ibnusina339/Remora/docs/UNRELEASED.md

# Perubahan belum dirilis

Perubahan sesi ini dikumpulkan pada [catatan v0.3.0](releases/v0.3.0.md). Belum ada perubahan tambahan yang dicatat.

Auto Off dan perbaikan temuan board: [v0.4.0](releases/v0.4.0.md).
