ibnusina339/Remora/docs/releases/v0.4.2.md

# REMORA v0.4.2

27 Oktober 2026

- Koneksi untuk SSID yang memiliki beberapa akses poin memindai seluruh kanal dan mengutamakan sinyal terkuat. ESP32-C6 memakai radio 2,4 GHz; SSID dual-band dengan nama yang sama tetap memakai varian 2,4 GHz.
- Kanal dan BSSID tidak dikunci ke hasil koneksi lama. Batas RSSI ditetapkan eksplisit dan setiap akses poin diberi satu retry sebelum kandidat berikutnya dicoba. Ambang keamanan jaringan terbuka/WPA2 tetap dipertahankan.
- Perlindungan idle saat mencoba koneksi tetap 20 detik; ini bukan batas waktu keras driver. Timer hemat Wi-Fi dan perlindungan OTA tetap berlaku.
- Pengujian sumber jaringan kini 14 kasus, termasuk konfigurasi jaringan terbuka, terlindungi, dan koneksi ulang yang tersimpan. Peta partisi dan userdata schema tetap sama; profil dan rekor tidak dihapus.

Tidak ada dukungan radio 5 GHz yang ditambahkan: ini batas hardware ESP32-C6. Jika varian 2,4 GHz SSID tidak terjangkau, koneksi tidak dapat digantikan dengan varian 5 GHz.

Rujukan konfigurasi: [header ESP-IDF 5.5.2](https://github.com/espressif/esp-idf/blob/v5.5.2/components/esp_wifi/include/esp_wifi_types_generic.h), [spesifikasi C6](https://www.espressif.com/en/products/socs/esp32-c6).
