ibnusina339/Remora/assets/cat-sprites/bowl-cutout.png

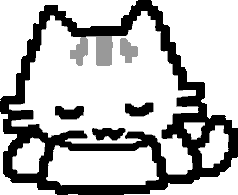
assets/cat-sprites/bowl-cutout.png
