ibnusina339/Remora/assets/cat-sprites/groom-cutout.png

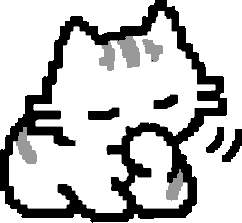
assets/cat-sprites/groom-cutout.png
