ibnusina339/Remora/assets/cat-sprites/happy-cutout.png

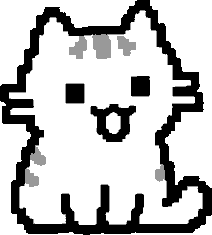
assets/cat-sprites/happy-cutout.png
