ibnusina339/Remora/assets/cat-sprites/peek-cutout.png

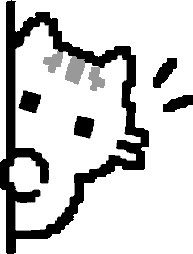
assets/cat-sprites/peek-cutout.png
