ibnusina339/Remora/assets/cat-sprites/roll-cutout.png

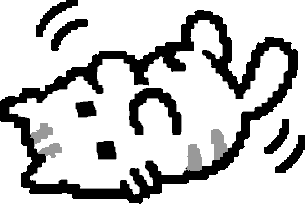
assets/cat-sprites/roll-cutout.png
