ibnusina339/Remora/assets/cat-sprites/secretStand-cutout.png

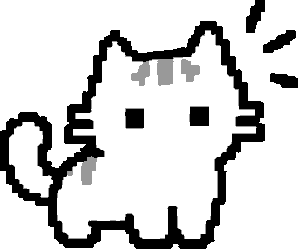
assets/cat-sprites/secretStand-cutout.png
