ibnusina339/Remora/assets/cat-sprites/sit-cutout.png

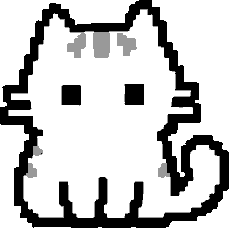
assets/cat-sprites/sit-cutout.png
