ibnusina339/Remora/assets/cat-sprites/sit.png

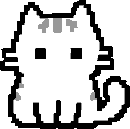
assets/cat-sprites/sit.png
