ibnusina339/Remora/assets/cat-sprites/sleep-cutout.png

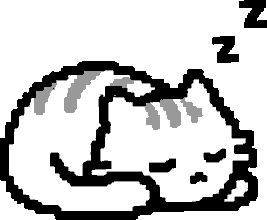
assets/cat-sprites/sleep-cutout.png
