ibnusina339/Remora/assets/cat-sprites/source-sheet.png

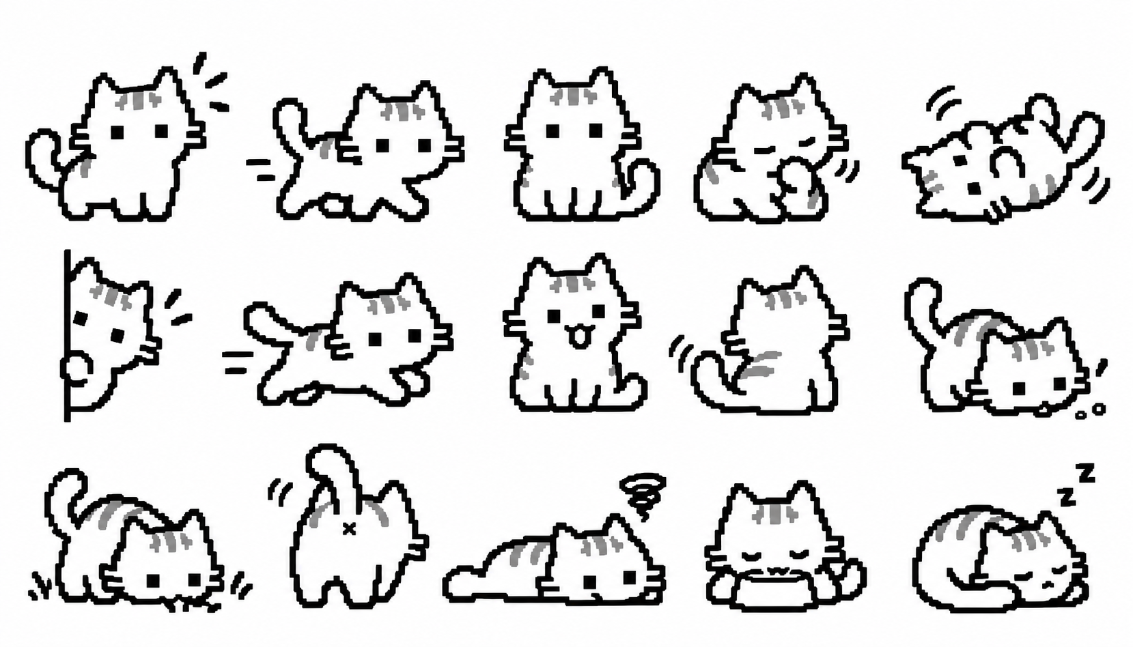
assets/cat-sprites/source-sheet.png
