ibnusina339/Remora/assets/cow-sprites/alert-cutout.png

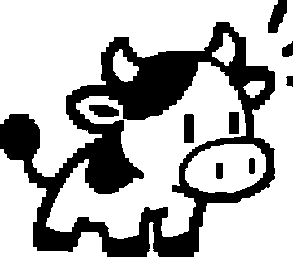
assets/cow-sprites/alert-cutout.png
