ibnusina339/Remora/assets/cow-sprites/back-cutout.png

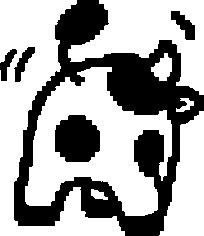
assets/cow-sprites/back-cutout.png
