ibnusina339/Remora/assets/cow-sprites/drink-cutout.png

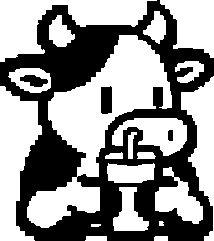
assets/cow-sprites/drink-cutout.png
