ibnusina339/Remora/assets/cow-sprites/easy-cutout.png

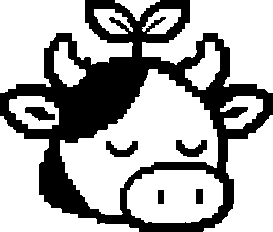
assets/cow-sprites/easy-cutout.png
