ibnusina339/Remora/assets/cow-sprites/expert-cutout.png

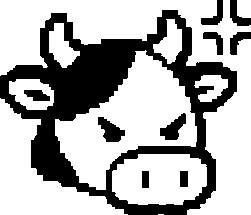
assets/cow-sprites/expert-cutout.png
