ibnusina339/Remora/assets/cow-sprites/graze-cutout.png

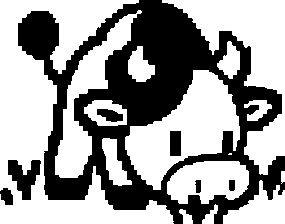
assets/cow-sprites/graze-cutout.png
