ibnusina339/Remora/assets/cow-sprites/happy-cutout.png

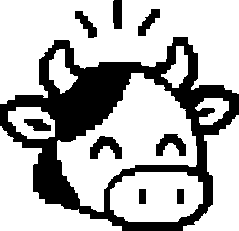
assets/cow-sprites/happy-cutout.png
