ibnusina339/Remora/assets/cow-sprites/hard-cutout.png

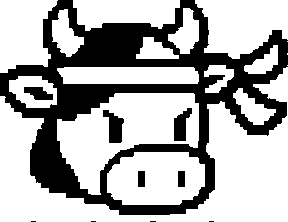
assets/cow-sprites/hard-cutout.png
