ibnusina339/Remora/assets/cow-sprites/jump-cutout.png

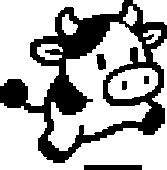
assets/cow-sprites/jump-cutout.png
