ibnusina339/Remora/assets/cow-sprites/listen-cutout.png

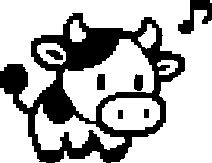
assets/cow-sprites/listen-cutout.png
