ibnusina339/Remora/assets/cow-sprites/master-cutout.png

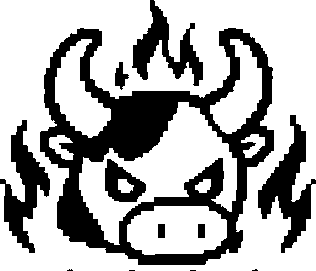
assets/cow-sprites/master-cutout.png
