ibnusina339/Remora/assets/cow-sprites/normal-cutout.png

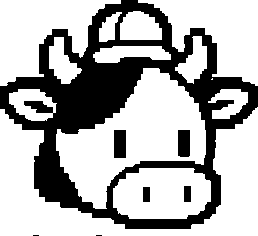
assets/cow-sprites/normal-cutout.png
