ibnusina339/Remora/assets/cow-sprites/peek-cutout.png

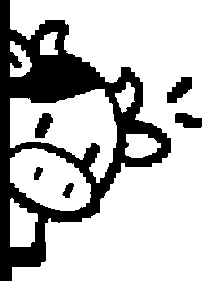
assets/cow-sprites/peek-cutout.png
