ibnusina339/Remora/assets/cow-sprites/pingpong-cutout.png

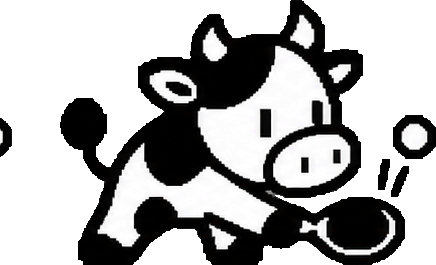
assets/cow-sprites/pingpong-cutout.png
