ibnusina339/Remora/assets/cow-sprites/roll-cutout.png

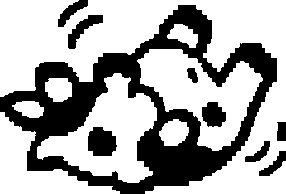
assets/cow-sprites/roll-cutout.png
