ibnusina339/Remora/assets/cow-sprites/run-cutout.png

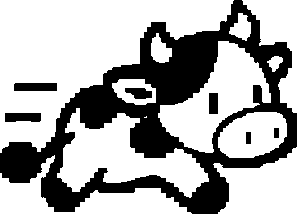
assets/cow-sprites/run-cutout.png
