ibnusina339/Remora/assets/cow-sprites/sad-cutout.png

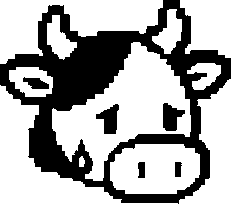
assets/cow-sprites/sad-cutout.png
