ibnusina339/Remora/assets/cow-sprites/sit-cutout.png

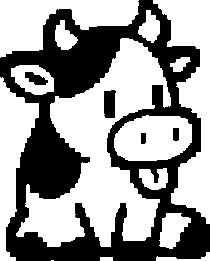
assets/cow-sprites/sit-cutout.png
