ibnusina339/Remora/assets/cow-sprites/sleep-cutout.png

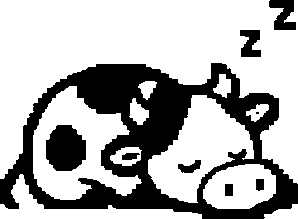
assets/cow-sprites/sleep-cutout.png
