ibnusina339/Remora/assets/cow-sprites/snake-cutout.png

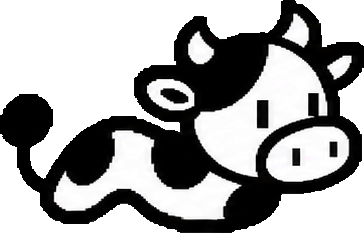
assets/cow-sprites/snake-cutout.png
