ibnusina339/Remora/assets/cow-sprites/source-pong-sheet.png

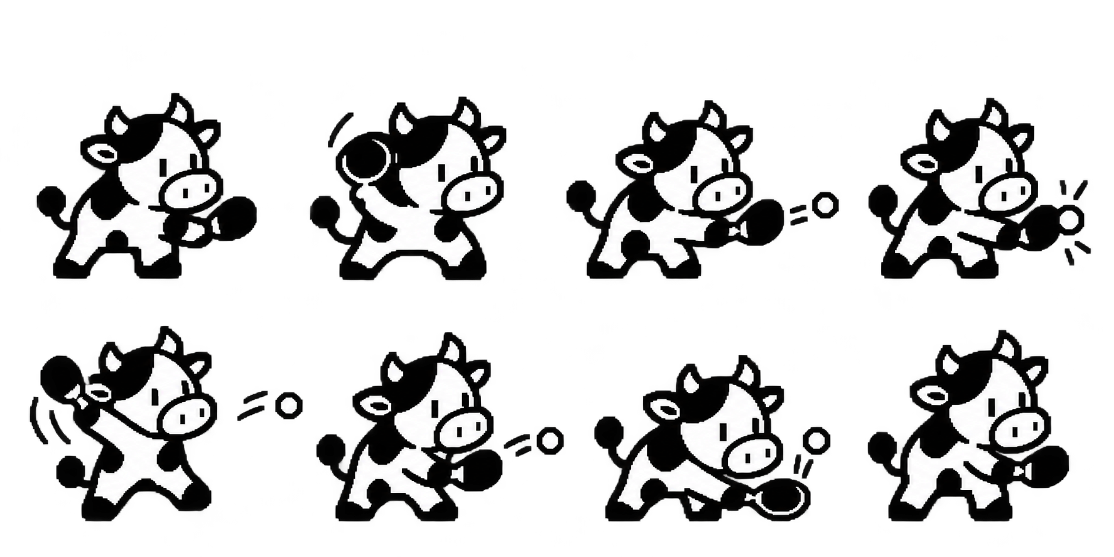
assets/cow-sprites/source-pong-sheet.png
