ibnusina339/Remora/assets/cow-sprites/source-snake-sheet.png

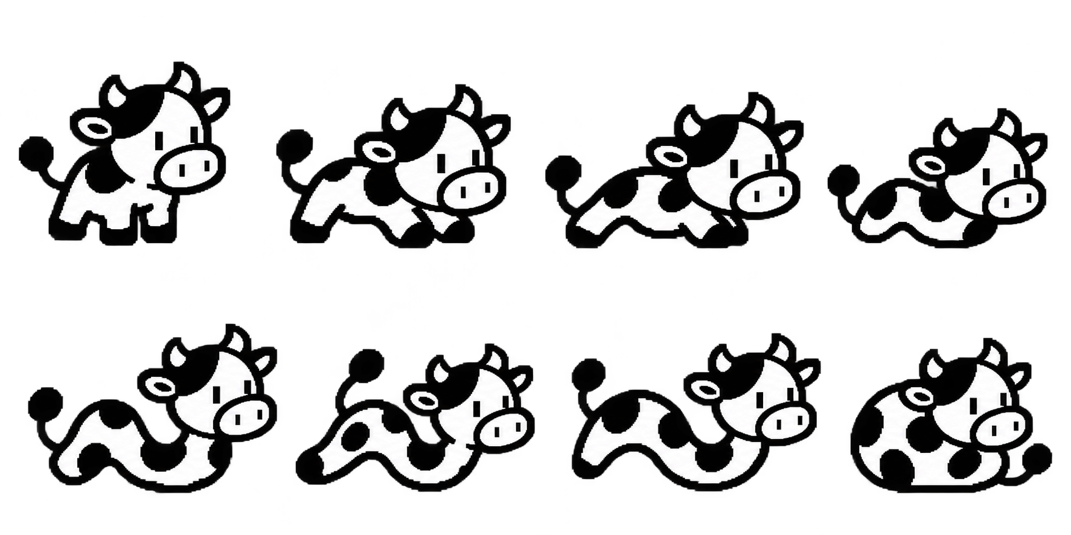
assets/cow-sprites/source-snake-sheet.png
