ibnusina339/Remora/assets/cow-sprites/stand-cutout.png

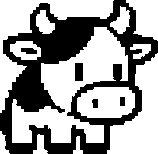
assets/cow-sprites/stand-cutout.png
