ibnusina339/Remora/assets/cow-sprites/surprised-cutout.png

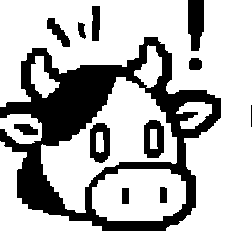
assets/cow-sprites/surprised-cutout.png
