ibnusina339/Remora/assets/cow-sprites/think-cutout.png

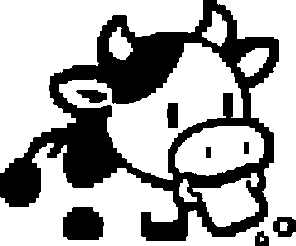
assets/cow-sprites/think-cutout.png
