ibnusina339/Remora/assets/remora-logo-fusion-r12.dxf

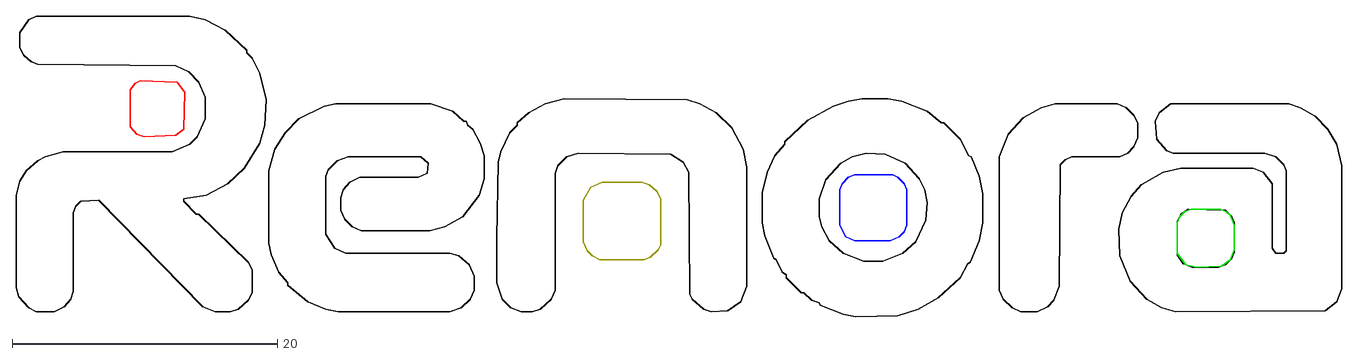
[picture p36: CAD file, 2026-10-23]
assets/remora-logo-fusion-r12.dxf
100.0 x 22.7
