ibnusina339/Remora/docs/hardware/REMORA_Schematic_Rev_K2_A4.pdf

# REMORA Schematic

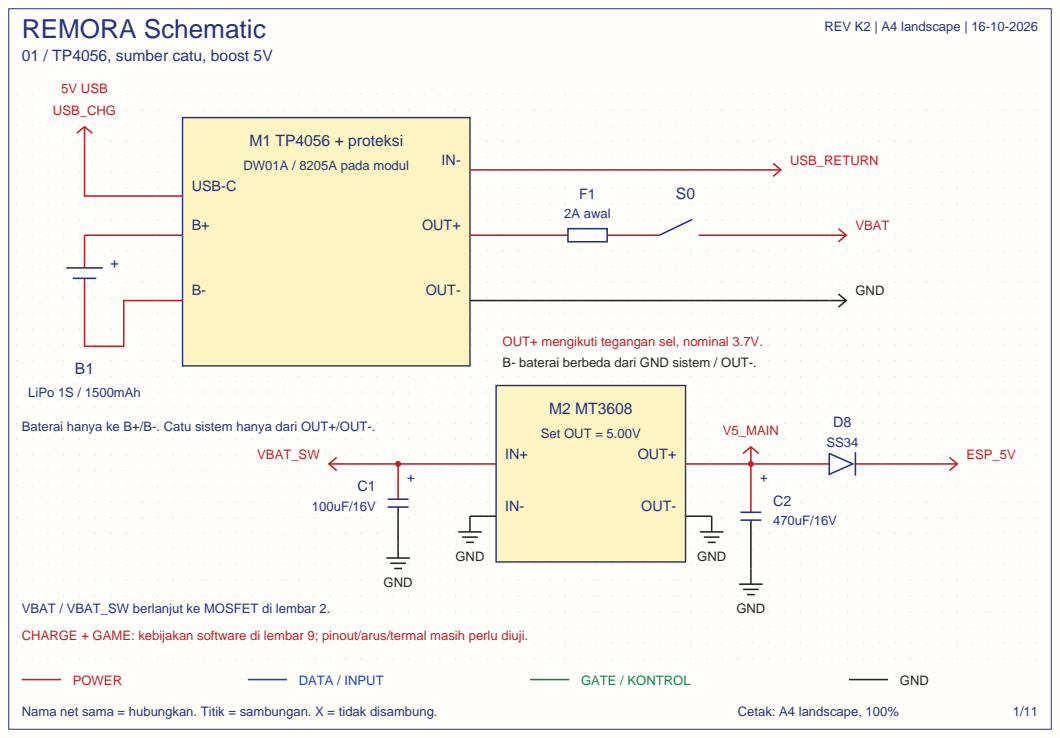
[picture p37: page 1]
REV K2 | A4 landscape | 16-10-2026; POWER; DATA / INPUT; GATE / KONTROL; GND; Nama net sama = hubungkan. Titik = sambungan. X = tidak disambung.; Cetak: A4 landscape, 100%; M1 TP4056 + proteksi; DW01A / 8205A pada modul; USB-C; OUT+; OUT-; USB_RETURN; USB_CHG; 5V USB; LiPo 1S / 1500mAh; F1 2A awal; VBAT; Set OUT = 5.00V; VBAT_SW; V5_MAIN; ESP_5V

01 / TP4056, sumber catu, boost 5V

OUT+ mengikuti tegangan sel, nominal 3.7V.
B- baterai berbeda dari GND sistem / OUT-.

Baterai hanya ke B+/B-. Catu sistem hanya dari OUT+/OUT-.

VBAT / VBAT_SW berlanjut ke MOSFET di lembar 2.
CHARGE + GAME: kebijakan software di lembar 9; pinout/arus/termal masih perlu diuji.

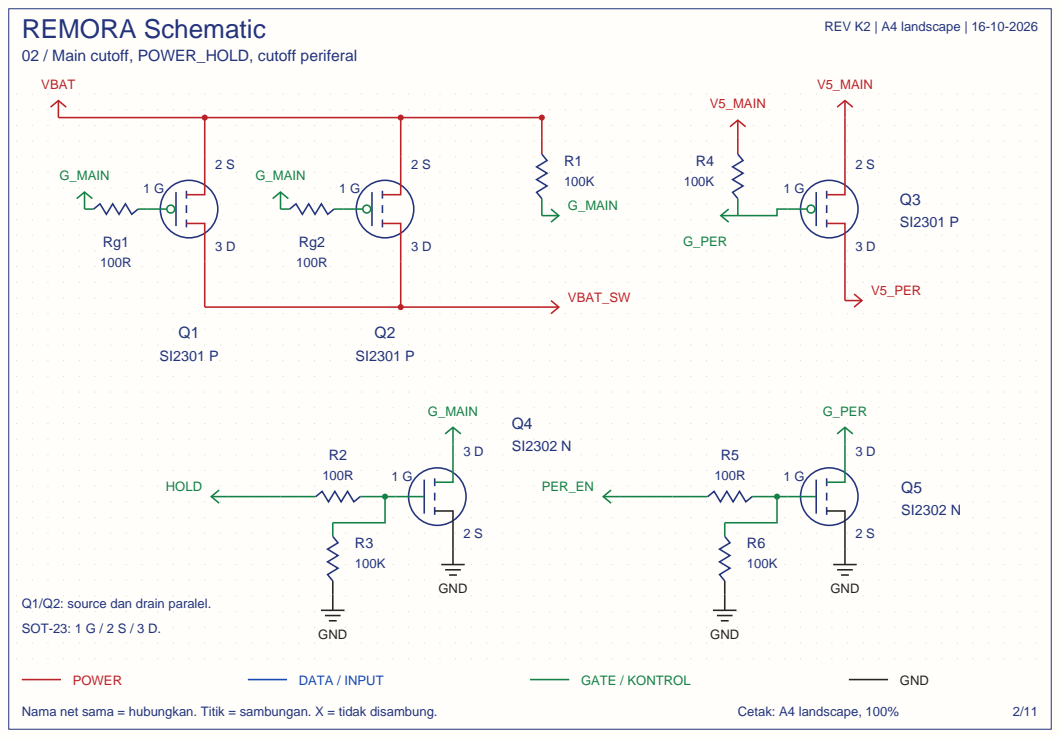
[picture p38: page 2]

02 / Main cutoff, POWER_HOLD, cutoff periferal

Q1/Q2: source dan drain paralel.
SOT-23: 1 G / 2 S / 3 D.

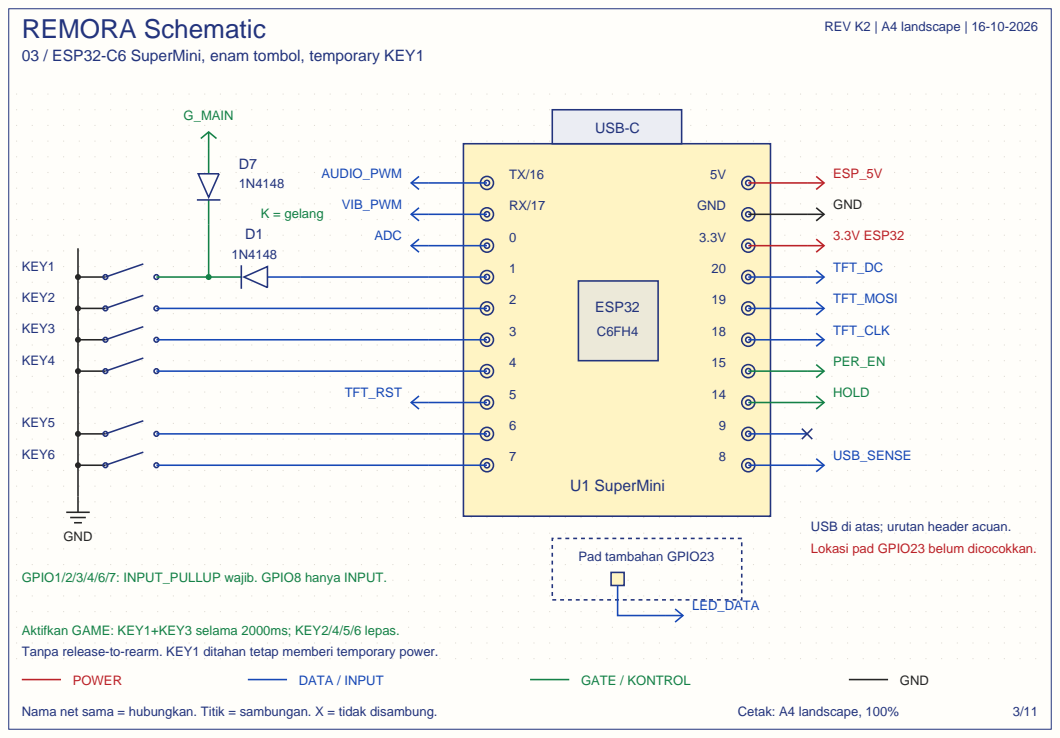
[picture p39: page 3]
POWER; DATA / INPUT; GATE / KONTROL; GND; Nama net sama = hubungkan. Titik = sambungan. X = tidak disambung.; Cetak: A4 landscape, 100%; USB-C; ESP32; U1 SuperMini; AUDIO_PWM; VIB_PWM; ADC; TFT_RST; ESP_5V; 3.3V ESP32; TFT_DC; TFT_MOSI; TFT_CLK; PER_EN; HOLD; USB_SENSE; Pad tambahan GPIO23; LED_DATA; KEY1; G_MAIN; K = gelang; KEY2; KEY3; KEY4; KEY5; KEY6

03 / ESP32-C6 SuperMini, enam tombol, temporary KEY1

USB di atas; urutan header acuan.
Lokasi pad GPIO23 belum dicocokkan.

GPIO1/2/3/4/6/7: INPUT_PULLUP wajib. GPIO8 hanya INPUT.

Aktifkan GAME: KEY1+KEY3 selama 2000ms; KEY2/4/5/6 lepas.
Tanpa release-to-rearm. KEY1 ditahan tetap memberi temporary power.

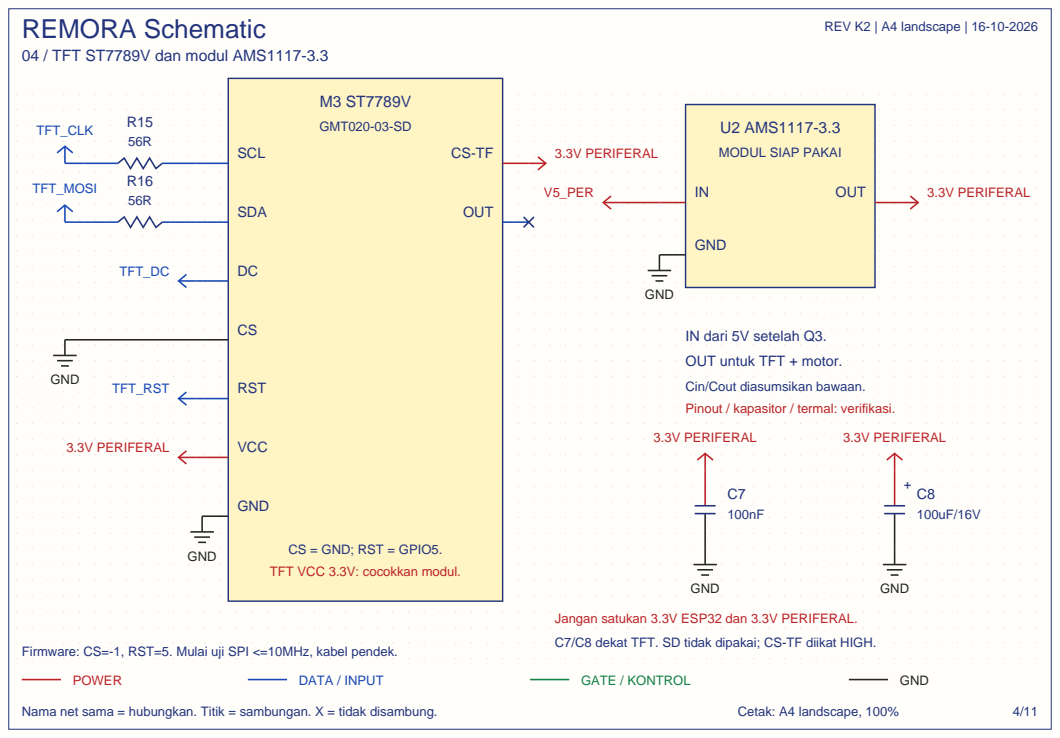
[picture p40: page 4]
POWER; DATA / INPUT; GATE / KONTROL; GND; Nama net sama = hubungkan. Titik = sambungan. X = tidak disambung.; Cetak: A4 landscape, 100%; GMT020-03-SD; SCL; SDA; RST; VCC; OUT; TFT_CLK; TFT_MOSI; TFT_DC; TFT_RST; 3.3V PERIFERAL; V5_PER

04 / TFT ST7789V dan modul AMS1117-3.3

U2 AMS1117-3.3
MODUL SIAP PAKAI (https://htmlapp.alldatasheet.com/html-pdf/205679/ADMOS/AMS1117/618/4/AMS1117.html)

IN dari 5V setelah Q3.
OUT untuk TFT + motor.
Cin/Cout diasumsikan bawaan.
Pinout / kapasitor / termal: verifikasi.

CS = GND; RST = GPIO5.
TFT VCC 3.3V: cocokkan modul.

Jangan satukan 3.3V ESP32 dan 3.3V PERIFERAL.

C7/C8 dekat TFT. SD tidak dipakai; CS-TF diikat HIGH. Firmware: CS=-1, RST=5. Mulai uji SPI <=10MHz, kabel pendek.

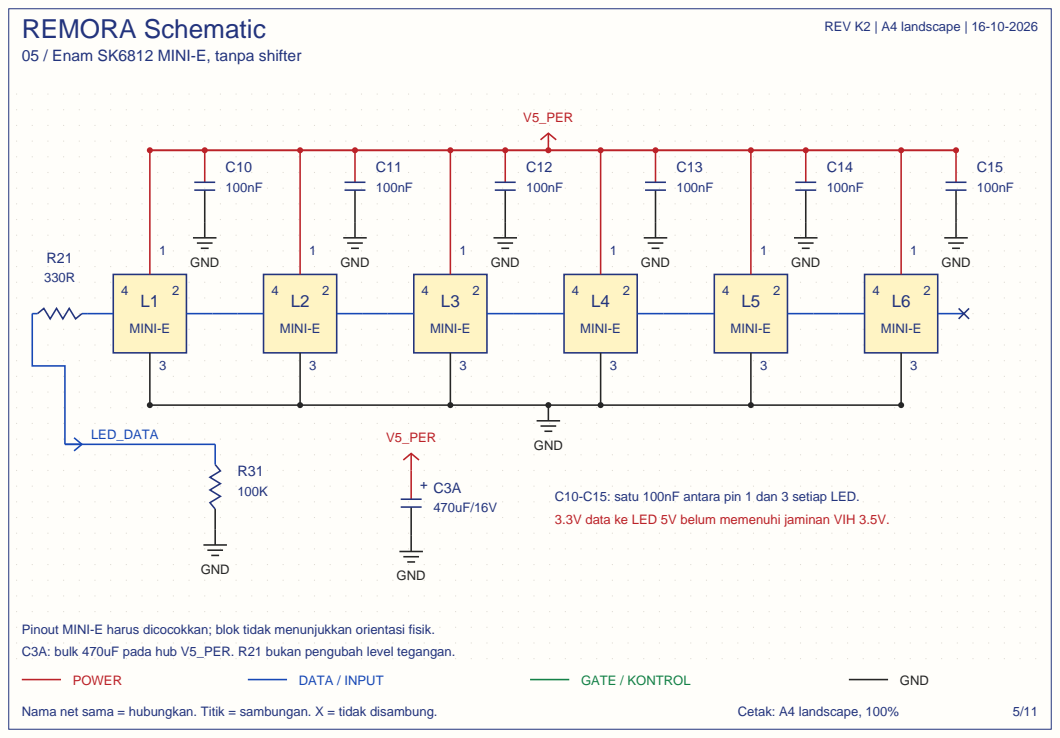
[picture p41: page 5]

05 / Enam SK6812 MINI-E, tanpa shifter

C10-C15: satu 100nF antara pin 1 dan 3 setiap LED.
3.3V data ke LED 5V belum memenuhi jaminan VIH 3.5V.

Pinout MINI-E harus dicocokkan; blok tidak menunjukkan orientasi fisik.
C3A: bulk 470uF pada hub V5_PER. R21 bukan pengubah level tegangan.

### 06 / Audio PWM, PAM8302A, speaker

POWER | DATA / INPUT | GATE / KONTROL | GND
Nama net sama = hubungkan. Titik = sambungan. X = tidak disambung. | Cetak: A4 landscape, 100% | 6/11

### M5 PAM8302A (https://cdn-shop.adafruit.com/datasheets/PAM8302A.pdf)

A+

A-

SD

Vin

GND

SPK+

SPK-

AUDIO_PWM R24 100K

C21
10nF

GND

R27
10K

GND

C23
100nF

GND

V5_PER

V5_PER

GND

### SPK1

8R / >=1W
+

C25
220uF/16V

+

V5_PER

GND

C25 dekat Vin / GND PAM8302.

PWM awal >=80kHz / 8 bit. Filter 1 tahap; respons audio belum diuji.
SD disatukan ke Vin: audio mengikuti cutoff Q3. Klik ON/OFF mungkin.

GPIO16 adalah TX saat boot; UI status hanya boleh setelah output disiapkan.

SPK+ dan SPK- hanya ke speaker; tidak ke GND.

### 07 / Modul vibration motor dan sensor baterai

POWER | DATA / INPUT | GATE / KONTROL | GND
Nama net sama = hubungkan. Titik = sambungan. X = tidak disambung. | Cetak: A4 landscape, 100% | 7/11

### M4 VIBRATION

DRIVER SUDAH PADA MODUL

IN

VCC

GND

VIB_PWM | R22 1K
VIB_IN

R30
100K

VIB_IN

GND

3.3V PERIFERAL

GND

C20
100uF/16V

+

3.3V PERIFERAL

GND

VCC 3.3V dan polaritas IN: cocokkan motor / driver.
C20 dekat modul motor; proteksi lonjakan bawaan belum diperiksa.

R12
100K

VBAT_SW

R13
47K

GND

ADC

C6
100nF

GND

ADC = GPIO0 pada lembar 3. Vbat_sw = Vadc x 147/47.
Pada 4.2V: ADC sekitar 1.343V. C6 dekat GPIO0; kalibrasi ADC.

KANDIDAT: pinout board, TP4056/LiPo, level LED dan uji listrik belum tervalidasi.

### 08 / PC817: deteksi USB untuk software lock; tanpa pemutus J1

POWER | DATA / INPUT | GATE / KONTROL | GND
Nama net sama = hubungkan. Titik = sambungan. X = tidak disambung. | Cetak: A4 landscape, 100% | 8/11

### U3 PC817

DIP4 / tampak atas (https://global.sharp/products/device/lineup/data/pdf/datasheet/PC817XxNSZ1B_e.pdf)

1 A

2 K

4 C

3 E

USB_CHG

R33
560R

USB_RETURN

USB_SENSE

R34
10K

3.3V ESP32

GND

Ke GPIO8 U1

USB TP masuk: GPIO8 LOW. USB TP dilepas: GPIO8 HIGH.
R33 560R membatasi IRED; sekitar 6.8mA pada USB 5V dan VF 1.2V.
R34 10K pull-up dari header 3.3V SuperMini / 3.3V ESP32; bukan 3.3V PERIFERAL. USB_RETURN ke IN- TP4056; GND ke OUT- TP4056. Jangan tambah jumper antar keduanya. GPIO8 hanya INPUT; nonaktifkan driver LED RGB bawaan pada GPIO8. (https://docs.espressif.com/projects/esp-idf/en/stable/esp32c6/api-reference/peripherals/gpio.html)
J1/Q6 pemutus dihapus. Catu ESP tetap melalui D8 pada lembar 1.
Standby: HOLD HIGH ditahan; PER_EN LOW; gunakan Light-sleep. (https://docs.espressif.com/projects/esp-idf/en/stable/esp32c6/api-reference/system/sleep_modes.html)
PC817 memisahkan jalur deteksi; tidak mengisolasi seluruh perangkat / charger.
Flash USB ESP: S0 OFF + USB TP dilepas. GPIO9 HIGH saat boot SPI normal.
S0 OFF: tidak ada popup otomatis. Validasi pinout DIP, LOW/HIGH GPIO8 dan arus standby.

### 09 / Software lock dan tampilan status dari standby

POWER | DATA / INPUT | GATE / KONTROL | GND
Nama net sama = hubungkan. Titik = sambungan. X = tidak disambung. | Cetak: A4 landscape, 100% | 9/11

Estimasi baterai dari ADC bukan pengukur kapasitas yang presisi. (https://www.ti.com/product-category/battery-management-ics/battery-fuel-gauges/overview.html)
Lock 80% memblokir GAME; pengisian tetap berjalan sampai USB dilepas.
MAIN OFF | S0 OFF / proteksi terputus | Tidak ada popup otomatis. Nyalakan dengan tombol setelah catu tersedia.
PLAY | KEY1+KEY3 valid 2 detik; tidak ada low lock / charge lock | Game boleh berjalan saat USB TP terpasang, selama estimasi belum mencapai lock 80%.
LOCK 80% | USB TP hadir dan estimasi >=80% | Pause/simpan game; tampilkan perintah cabut USB. Setelah 2 detik, periferal OFF; ESP standby.
LOW 5% | Estimasi <=5% atau low-voltage warning hasil kalibrasi | Game berhenti; tampilkan baterai rendah 2 detik. Standby; game dibuka setelah pulih, contoh >=10%.
USB POPUP | USB TP dipasang saat standby | Tampilkan USB terhubung + estimasi persen 2 detik. Kembali standby; ini bukan pembuktian arus charge.
RESUME | USB dilepas setelah lock 80%; baterai cukup untuk bermain | Buka lock; lanjutkan dengan combo 2 detik. KEY1/KEY3 tetap input game tanpa release-to-rearm.

Standby: HOLD HIGH + pad hold; PER_EN LOW + semua output periferal LOW. (https://docs.espressif.com/projects/esp-idf/en/stable/esp32c6/api-reference/peripherals/gpio.html)
Wake GPIO8 pada level berikutnya (USB masuk/lepas); jangan arm level yang sudah aktif. GPIO wake Light-sleep: domain GPIO tetap ON. KEY1 membangunkan; timer memantau ADC. (https://docs.espressif.com/projects/esp-idf/en/stable/esp32c6/api-reference/system/sleep_modes.html) Tambahkan batas tegangan kritis sesuai sel: cutoff penuh bila perlu; persentase bukan proteksi.

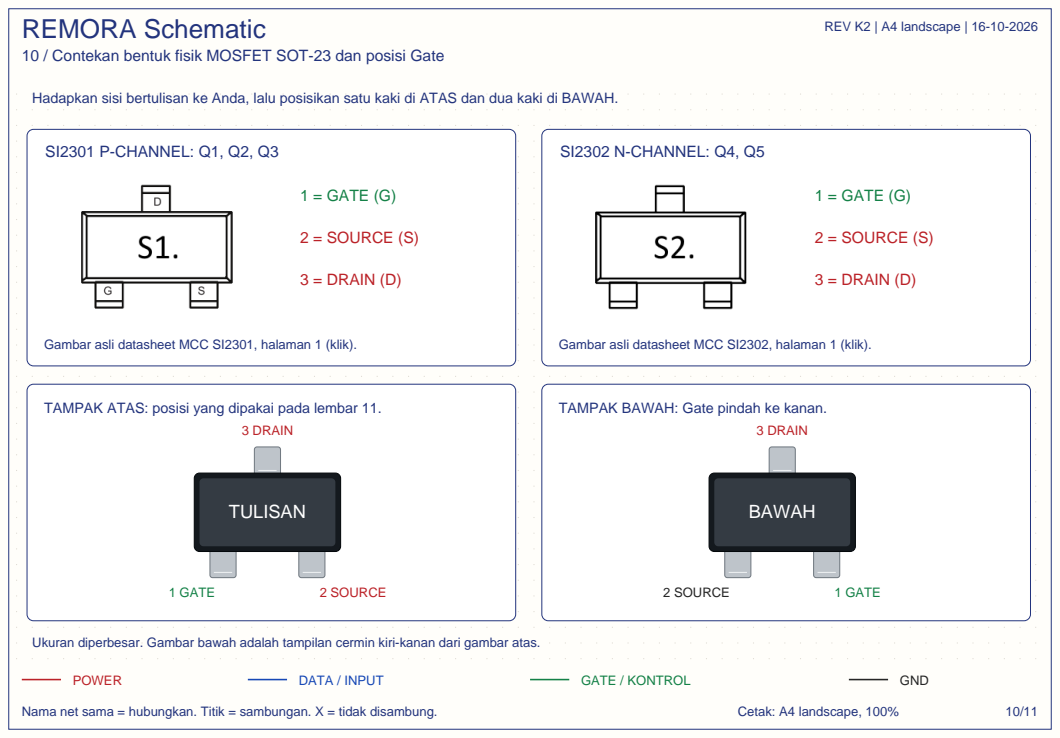
[picture p42: page 10]
POWER; DATA / INPUT; GATE / KONTROL; GND; Nama net sama = hubungkan. Titik = sambungan. X = tidak disambung.; Cetak: A4 landscape, 100%; SI2301 P-CHANNEL: Q1, Q2, Q3; 1 = GATE (G); 2 = SOURCE (S); 3 = DRAIN (D); SI2302 N-CHANNEL: Q4, Q5; TAMPAK ATAS: posisi yang dipakai pada lembar 11.; TAMPAK BAWAH: Gate pindah ke kanan.; TULISAN; 3 DRAIN; 1 GATE; 2 SOURCE; BAWAH

10 / Contekan bentuk fisik MOSFET SOT-23 dan posisi Gate

Hadapkan sisi bertulisan ke Anda, lalu posisikan satu kaki di ATAS dan dua kaki di BAWAH.

Gambar asli datasheet MCC SI2301, halaman 1 (klik). (https://www.mccsemi.com/pdf/Products/SI2301(SOT-23).pdf)

Gambar asli datasheet MCC SI2302, halaman 1 (klik). (https://www.mccsemi.com/pdf/Products/SI2302(SOT-23).pdf)

Ukuran diperbesar. Gambar bawah adalah tampilan cermin kiri-kanan dari gambar atas.

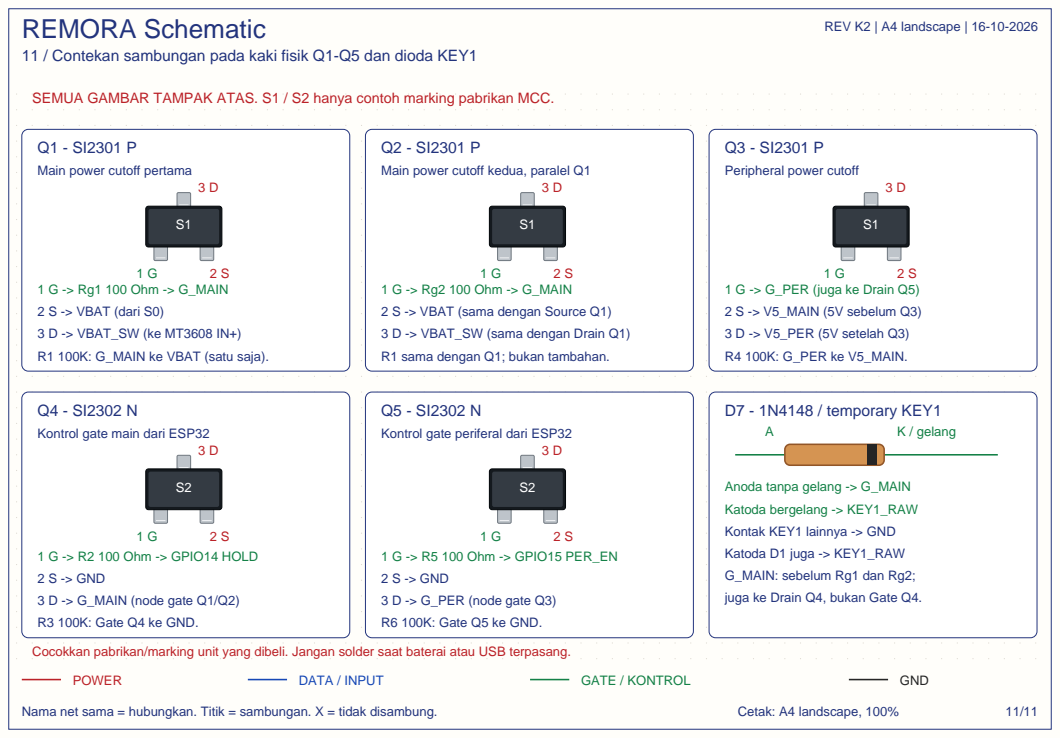
[picture p43: page 11]

11 / Contekan sambungan pada kaki fisik Q1-Q5 dan dioda KEY1

SEMUA GAMBAR TAMPAK ATAS. S1 / S2 hanya contoh marking pabrikan MCC.

Main power cutoff pertama

Main power cutoff kedua, paralel Q1

1 G -> Rg1 100 Ohm -> G_MAIN
2 S -> VBAT (dari S0)
3 D -> VBAT_SW (ke MT3608 IN+)
R1 100K: G_MAIN ke VBAT (satu saja).

1 G -> Rg2 100 Ohm -> G_MAIN
2 S -> VBAT (sama dengan Source Q1)
3 D -> VBAT_SW (sama dengan Drain Q1)
R1 sama dengan Q1; bukan tambahan.

Kontrol gate main dari ESP32

Kontrol gate periferal dari ESP32

Anoda tanpa gelang -> G_MAIN
Katoda bergelang -> KEY1_RAW
Kontak KEY1 lainnya -> GND
Katoda D1 juga -> KEY1_RAW
G_MAIN: sebelum Rg1 dan Rg2;
juga ke Drain Q4, bukan Gate Q4.

Cocokkan pabrikan/marking unit yang dibeli. Jangan solder saat baterai atau USB terpasang.
