ibnusina339/Remora/firmware/esp32c6/components/remora_board/src/audio.cpp

#include "board.hpp"
#include "meow_samples.hpp"
#include "driver/ledc.h"
#include "driver/gpio.h"
#include "hal/ledc_ll.h"
#include "esp_timer.h"
#include "esp_random.h"
#include "freertos/FreeRTOS.h"
#include "freertos/queue.h"
#include <algorithm>
#include <cstring>
#include <atomic>
#include <initializer_list>
namespace remora {
struct CueNote{int hz,ms;};
static QueueHandle_t notes;static esp_timer_handle_t timer;
static std::atomic<int>master{70},music{35},effects{75},cue{0},duration{0},sample{-1},sampleAt{0};
static std::atomic<bool>menu{false},running{false},sampling{false};
static portMUX_TYPE audioLock=portMUX_INITIALIZER_UNLOCKED;
static uint32_t phase=0,bassPhase=0,ticks=0;
static int noteLength=0,last=-1,lastDuty=-1;static int64_t vibUntil=0;
static bool audibleWork(){
 return running.load()&&master.load()>0&&((menu.load()&&music.load()>0)||
   (effects.load()>0&&(sample.load()>=0||duration.load()>0||(notes&&uxQueueMessagesWaiting(notes)>0))));
}
// Audio owns LEDC channel 0. IDF 5.5.2's C6 ledc_set_duty rewrites all
// 16 gamma ranges (160 us of sync delays), exceeding an 8 kHz sample period.
// Driver initialization sets the non-fading ranges once; samples only latch
// the integer duty using the same LL update sequence as ledc_update_duty.
// audioLock also prevents a pending callback from re-enabling stopped audio.
static void dutyLocked(int duty){
 if(!running.load()||duty==lastDuty)return;
 auto*hw=LEDC_LL_GET_HW();
 ledc_ll_set_duty_int_part(hw,LEDC_LOW_SPEED_MODE,LEDC_CHANNEL_0,duty);
 ledc_ll_set_sig_out_en(hw,LEDC_LOW_SPEED_MODE,LEDC_CHANNEL_0,true);
 ledc_ll_set_duty_start(hw,LEDC_LOW_SPEED_MODE,LEDC_CHANNEL_0);
 ledc_ll_ls_channel_update(hw,LEDC_LOW_SPEED_MODE,LEDC_CHANNEL_0);
 lastDuty=duty;
}
static void writeDuty(int duty){
 portENTER_CRITICAL(&audioLock);dutyLocked(duty);portEXIT_CRITICAL(&audioLock);
}
static void silenceLocked(){
 if(!running.load()||lastDuty<0)return;
 auto*hw=LEDC_LL_GET_HW();
 ledc_ll_set_idle_level(hw,LEDC_LOW_SPEED_MODE,LEDC_CHANNEL_0,0);
 ledc_ll_set_sig_out_en(hw,LEDC_LOW_SPEED_MODE,LEDC_CHANNEL_0,false);
 ledc_ll_ls_channel_update(hw,LEDC_LOW_SPEED_MODE,LEDC_CHANNEL_0);
 lastDuty=-1;
}
static void startSampling(){
 esp_err_t result=ESP_OK;
 // These timer APIs only manipulate the timer list; neither waits for a
 // callback. Serialize the claim/start with stop on the single-core C6.
 portENTER_CRITICAL(&audioLock);
 bool expected=false;
 if(timer&&audibleWork()&&sampling.compare_exchange_strong(expected,true)){
   result=esp_timer_start_periodic(timer,125);
   if(result!=ESP_OK)sampling=false;
 }
 portEXIT_CRITICAL(&audioLock);
 ESP_ERROR_CHECK(result);
}
static void stopIfIdle(){
 portENTER_CRITICAL(&audioLock);
 if(!audibleWork()){
   silenceLocked();
   if(sampling.load())esp_timer_stop(timer);
   sampling=false;
 }
 portEXIT_CRITICAL(&audioLock);
 // A producer may have queued a cue while the old clock was still active.
 // Recheck after publishing idle so that its wake-up cannot be lost.
 startSampling();
}
static void tick(void*){
 if(!running.load())return;
 int mix=0,n=sample.load();if(n>=0){int p=sampleAt++;if(unsigned(p)<MeowLengths[n])mix+=(int(Meows[n][p])-128)*effects.load()/100;else sample=-1;}
 int remain=duration.load();if(remain<=0&&notes){CueNote next;if(xQueueReceive(notes,&next,0)==pdTRUE){cue=next.hz;noteLength=next.ms*8;duration=remain=noteLength;}}
 if(remain>0){duration=remain-1;phase+=uint32_t(cue.load())*65536/8000;int triangle=(phase>>8)&255;triangle=triangle<128?triangle:255-triangle;int envelope=std::min(160,std::min(remain,noteLength-remain));mix+=(triangle-64)*effects.load()/100*envelope/160;}
 if(menu.load()&&music.load()>0){const int melody[]={330,392,494,392,330,294,262,0,294,349,440,349,294,262,247,0};int hz=melody[(ticks/1200)%16];bassPhase+=hz*65536/8000;int a=(bassPhase>>8)&255;mix+=(a<128?a-64:191-a)*music.load()/500;}
 ticks++;mix=std::clamp(mix*master.load()/100,-120,120);writeDuty(128+mix);
 stopIfIdle();
}
void audioStart(){
 if(running.load())return;
 if(!notes){notes=xQueueCreate(12,sizeof(CueNote));ESP_ERROR_CHECK(notes?ESP_OK:ESP_ERR_NO_MEM);}
 ledc_timer_config_t t{};t.speed_mode=LEDC_LOW_SPEED_MODE;t.duty_resolution=LEDC_TIMER_8_BIT;t.timer_num=LEDC_TIMER_0;t.freq_hz=80000;t.clk_cfg=LEDC_AUTO_CLK;ESP_ERROR_CHECK(ledc_timer_config(&t));
 ledc_channel_config_t c{};c.gpio_num=AudioPin;c.speed_mode=LEDC_LOW_SPEED_MODE;c.channel=LEDC_CHANNEL_0;c.timer_sel=LEDC_TIMER_0;c.duty=128;c.intr_type=LEDC_INTR_DISABLE;ESP_ERROR_CHECK(ledc_channel_config(&c));
 ESP_ERROR_CHECK(ledc_stop(LEDC_LOW_SPEED_MODE,LEDC_CHANNEL_0,0));
 if(!timer){esp_timer_create_args_t a{};a.callback=tick;a.name="pcm8k";a.skip_unhandled_events=true;ESP_ERROR_CHECK(esp_timer_create(&a,&timer));}
 portENTER_CRITICAL(&audioLock);lastDuty=-1;running=true;portEXIT_CRITICAL(&audioLock);
 // Keep the 80 kHz timer configured, but disable output/work in silence.
 startSampling();
}
void audioStop(){
 portENTER_CRITICAL(&audioLock);
 bool wasRunning=running.exchange(false);
 if(wasRunning&&sampling.load())esp_timer_stop(timer);
 sampling=false;
 portEXIT_CRITICAL(&audioLock);
 if(!wasRunning)return;
 menu=false;duration=0;sample=-1;if(notes)xQueueReset(notes);
 // running=false and audioLock ensure no LL write can follow this stop.
 ledc_stop(LEDC_LOW_SPEED_MODE,LEDC_CHANNEL_0,0);
 gpio_set_level(gpio_num_t(VibrationPin),0);
}
bool audioSamplingActive(){return sampling.load();}
void audioVolumes(int a,int b,int c){
 master=std::clamp(a,0,100);music=std::clamp(b,0,100);effects=std::clamp(c,0,100);
 if(master.load()==0||effects.load()==0){duration=0;sample=-1;if(notes)xQueueReset(notes);}
 stopIfIdle();
}
void audioMenu(bool enabled){menu=enabled;stopIfIdle();}
static void melody(std::initializer_list<CueNote> sequence){
 if(!running.load()||!notes||master.load()==0||effects.load()==0)return;
 xQueueReset(notes);duration=0;for(const auto&note:sequence)xQueueSend(notes,&note,0);
 startSampling();
}

void audioEffect(const char*name){
 if(!running){return;}
 if(!std::strcmp(name,"fail"))melody({{392,110},{349,100},{294,140},{196,260}});
 else if(!std::strcmp(name,"recordFail"))melody({{659,80},{784,90},{988,120},{784,80},{392,100},{196,220}});
 else if(!std::strcmp(name,"clear"))melody({{523,90},{659,90},{784,90},{1046,180}});
 else if(!std::strcmp(name,"ratingSaved"))melody({{659,70},{784,90},{1046,170}});
 else if(!std::strcmp(name,"invite"))melody({{659,90},{784,130}});
 else if(!std::strcmp(name,"boot"))melody({{262,80},{330,80},{392,80},{523,140}});
 else if(!std::strcmp(name,"off"))melody({{523,120},{392,120},{262,160},{131,260}});
 else if(!std::strcmp(name,"portal"))melody({{330,45},{494,45},{740,65},{988,100}});
 else if(!std::strcmp(name,"bonus"))melody({{784,60},{988,60},{1175,110}});
 else if(!std::strcmp(name,"food"))melody({{784,60},{1046,110}});
 else if(!std::strcmp(name,"damage"))melody({{220,100},{147,170}});
 else if(!std::strcmp(name,"confirm"))melody({{392,55},{523,90}});
 else if(!std::strcmp(name,"back"))melody({{330,55},{262,70}});
 else if(!std::strcmp(name,"warning"))melody({{247,90},{220,110}});
 else if(!std::strcmp(name,"star"))melody({{784,45}});
 else if(!std::strcmp(name,"bounce"))melody({{740,45}});
 else if(!std::strcmp(name,"step"))melody({{196,35}});
 else if(!std::strcmp(name,"correct"))melody({{659,65},{784,65}});
 else if(!std::strcmp(name,"high"))melody({{880,170}});
 else if(!std::strcmp(name,"low"))melody({{220,170}});
 else melody({{520,55}});
}
void audioMeow(){if(!running.load()||master.load()==0||effects.load()==0){return;}int n=esp_random()%(last<0?6:5);if(n>=last&&last>=0)n++;last=n;sample=-1;sampleAt=0;sample=n;startSampling();}
void vibrate(int milliseconds){if(milliseconds>0){gpio_set_direction(gpio_num_t(VibrationPin),GPIO_MODE_OUTPUT);gpio_set_level(gpio_num_t(VibrationPin),1);vibUntil=esp_timer_get_time()+milliseconds*1000;}else if(vibUntil&&esp_timer_get_time()>=vibUntil){gpio_set_level(gpio_num_t(VibrationPin),0);vibUntil=0;}}
}
