ibnusina339/Remora/firmware/esp32c6/components/remora_core/include/game_feedback.hpp

#pragma once
namespace remora {
inline constexpr const char* WinPhrases[11][15]={
{"MOO-NTAP!","MEMORI SETAJAM TANDUK!","URUTAN MASUK KANDANG!","OTAK SAPI NAIK LEVEL!","INGATAN ANTI LUPA!","MOO, POLANYA TUNDUK!","JEMPOL DAN OTAK KOMPAK!","SUSU MEMORI PREMIUM!","POLA RAPI, HATI HAPPY!","SAPI CERDAS BERAKSI!","SEMUA LAMPU TERINGAT!","MOO-MORI SEMPURNA!","URUTAN TANPA CELA!","TANDUK INGATAN TAJAM!","KANDANG MEMORI AMAN!"},
{"MOO-NDUR DENGAN MULUS!","BALIK URUTAN, TETAP JAGO!","EKOR DULUAN, MENANG!","OTAK PUTAR BALIK!","REVERSE TANPA REM!","DARI AKHIR JADI JUARA!","MOO, DUNIA TERBALIK!","INGATAN BISA MUNDUR!","BALIK POLA BERES!","SAPI ANTI SALAH ARAH!","MUNDUR TAPI MAJU SKOR!","URUTAN BALIK SEMPURNA!","MEMORI DUA ARAH!","EKOR MENUNTUN KEMENANGAN!","PUTAR BALIK MOO-NTAP!"},
{"MOO-LESAT!","REFLEKS SECEPAT KILAT!","TANDUK MENDAHULUI ANGIN!","KEDIP KALAH CEPAT!","SINYAL LANGSUNG DISAMBUT!","SAPI MODE TURBO!","JARI SEPERTI PETIR!","GO LANGSUNG GAS!","MOO, REFLEKS TAJAM!","SINAR KALAH CEPAT!","TUNGGU TENANG, TEKAN KENCANG!","MATA DAN JARI KOMPAK!","SINYAL TEPAT SASARAN!","REAKSI SUSU SUPER!","KILAT DARI KANDANG!"},
{"MOO, JALAN KETEMU!","LABIRIN MASUK AKAL!","TANDUK JADI KOMPAS!","PORTAL TANPA NYASAR!","RUTE AMAN SAMPAI GOAL!","SAPI PENJELAJAH HEBAT!","JEJAKMU RAPI SEKALI!","BONUS IKUT KE KANDANG!","PETA DALAM INGATAN!","GOAL SUDAH DITAKLUKKAN!","LANGKAH TANPA TEMBOK!","MOO-PETA MASTER!","JALUR AMAN TERBUKA!","KOMPAS SAPI AKURAT!","PULANG TANPA NYASAR!"},
{"MOO-PUKUL TEPAT!","WARNA TUNDUK PADAMU!","HIJAU DISAMBUT CEPAT!","MERAH BERHASIL DIHINDARI!","DOUBLE TAP MOO-NTAP!","TAHAN DENGAN SABAR!","TETANGGA KENA SASARAN!","REFLEKS PENUH WARNA!","JARI ARCADE PREMIUM!","LAMPU TAK BISA MENIPU!","MOO, KOMBO PELANGI!","SEMUA ISYARAT TERBACA!","KANDANG ARCADE BERGEMURUH!","PUKULAN SAPI AKURAT!","PELENGI REFLEKS JUARA!"},
{"KENTANG SELAMAT!","MOO, BELUM GOSONG!","PANASNYA LEWAT!","TIMING PAS, KENTANG AMAN!","TANGKAP DI SAAT TEPAT!","KENTANG MASUK KANDANG!","SAPI TAHAN PANAS!","OPERAN MULUS SEKALI!","MOO-TATO JUARA!","API TIDAK MENGENA!","JARI DINGIN, SKOR PANAS!","POTATO BERHASIL DIJINAKKAN!","SINYAL PANAS TERKENDALI!","PUTARAN TANPA GOSONG!","KENTANG SUPER AMAN!"},
{"MOO, ARAHNYA BENAR!","KOMPAS OTAK BERPUTAR!","ROTASI TAK MENIPU!","UTARA MASUK KANDANG!","KIRI KANAN TETAP TENANG!","CERMIN BERHASIL DIBACA!","OTAK SPASIAL NAIK LEVEL!","SAPI NAVIGATOR HANDAL!","PUTAR PETA, TETAP TEPAT!","MOO-KOMPAS AKURAT!","ARAH BARU LANGSUNG PAHAM!","MAPPING MASUK INGATAN!","ROTASI TANPA PUSING!","JARI TAHU TUJUANNYA!","KOMPAS SAPI JUARA!"},
{"MOO, YANG HILANG KETEMU!","CELAH MEMORI TERTUTUP!","LAMPU HILANG TERINGAT!","DETEKTIF SAPI BERAKSI!","POLA KEMBALI UTUH!","PETUNJUK TAK TERLEWAT!","KUNCI MASUK KANDANG!","INGATAN MENGISI CELAH!","MOO-STERI TERPECAHKAN!","POSISI KOSONG TERJAWAB!","MATA MEMORI TAJAM!","JEJAK LAMPU KETEMU!","SEMUA KUNCI KEMBALI!","POLA HILANG TAK MENIPU!","DETEKTIF MEMORI JUARA!"},
{"MOO-KODE TERPECAHKAN!","BIT MASUK KANDANG!","SINYAL BERHASIL DIBACA!","NOL SATU TETAP JAGO!","TELINGA SAPI AKURAT!","KODE BINER TUNDUK!","HIGH LOW MOO-NTAP!","PESAN RAHASIA TERBUKA!","DECODER OTAK AKTIF!","BIT TERBALIK TETAP PAHAM!","SAPI AHLI KRIPTO!","POLARITAS TAK MENIPU!","KODE JADI ANGKA TEPAT!","MOO, PESANNYA JELAS!","SINYAL SUSU PREMIUM!"},
{"RUMPUT MASUK PERUT!","MOO-LAR MAKIN PANJANG!","ULAR SAPI KENYANG!","PADANG RUMPUT BERSIH!","EKOR PANJANG, OTAK TAJAM!","MOO, MAKANAN BERES!","TANDUK LOLOS PAGAR!","BELAK BELOK MOO-NTAP!","JEJAK RUMPUT SEMPURNA!","ULAR SUSU PREMIUM!","KEBUN SUDAH DIKUASAI!","SAPI PANJANG JUARA!","MAKAN TANPA MENABRAK!","RUMPUT SEGAR SEMUA!","MOO, PANEN SUKSES!"},
{"BOLA SUSU MASUK!","PANTULAN MOO-NTAP!","PAPAN KANDANG JUARA!","MOO, LAWAN TERLEWAT!","SERVIS SUSU PREMIUM!","SAPI JAGO PANTUL!","SUDUT TAJAM, SKOR NAIK!","LAPANGAN MILIKMU!","BOLA TANPA AMPUN!","MOO, RALLY BERES!","PANTUL KIRI KANAN!","SUSU TERKIRIM MULUS!","NET KANDANG BERGETAR!","PAPANMU KOKOH SEKALI!","MOO, POIN JUARA!"},
};
inline constexpr const char* LossTitles[11][5]={
{"MEMORI BARU BANGUN","INGATAN MULAI TAJAM","MEMORI MOO-NTAP","OTAK SUPER SAPI","REKOR MEMORI BARU"},
{"MASIH BELAJAR MUNDUR","BALIK POLA MULAI MULUS","MASTER PUTAR BALIK","EKOR MENJADI KOMPAS","REKOR REVERSE BARU"},
{"REFLEKS MASIH PEMANASAN","JARI MULAI SIGAP","SAPI SECEPAT KILAT","REFLEKS SUPERSONIK","REKOR KILAT BARU"},
{"PENJELAJAH BARU MULAI","KOMPAS MULAI AKURAT","PENAKLUK LABIRIN","PETA HIDUP DI OTAKMU","REKOR RUTE BARU"},
{"ARCADE MASIH PEMANASAN","WARNA MULAI TERBACA","JARI PELANGI JUARA","LEGENDA WHACK-A-LIGHT","REKOR ARCADE BARU"},
{"KENTANG MASIH HANGAT","TIMING MULAI MATANG","PENJINAK KENTANG PANAS","SAPI KEBAL GOSONG","REKOR POTATO BARU"},
{"KOMPAS BARU MENYALA","ROTASI MULAI DIPAHAMI","NAVIGATOR KANDANG","RAJA RUANG DAN ARAH","REKOR ARAH BARU"},
{"DETEKTIF BARU BANGUN","PETUNJUK MULAI TERBACA","PEMBURU KUNCI HILANG","MEMORI TANPA CELAH","REKOR DETEKTIF BARU"},
{"DECODER BARU MENYALA","BIT MULAI TERBACA","AHLI SINYAL KANDANG","MASTER BINER SAPI","REKOR DECODE BARU"},
{"ULAR BARU BANGUN","RUMPUT MULAI HABIS","ULAR SAPI JUARA","PENGUASA PADANG RUMPUT","REKOR ULAR BARU"},
{"PAPAN MASIH PEMANASAN","PANTULAN MULAI RAPI","JUARA BOLA SUSU","LEGENDA PONG KANDANG","REKOR PONG BARU"},
};
inline constexpr const char* LossEndings[23]={"MOO, COBA LAGI!","GAS PUTARAN LAGI!","TANDUKMU BELUM MENYERAH!","JARI SUDAH GAS, OTAK MASIH PARKIR.","PERCAYA DIRI DULU, BENAR BELAKANGAN.","STRATEGIMU: TEKAN DAN BERDOA?","MOO, TOMBOLNYA TIDAK PINDAH KOK.","JAGO JUGA. SAMPAI DETIK TERAKHIR.","MOO... SUDAH COBA, ITU BERARTI.","ADUH, SUDAH DEKAT. SAYANG SEKALI.","JARI CAPEK? ISTIRAHAT DULU, MOO.","TENANG, SAPI JUGA PERNAH SALAH.","USAHA BAGUSMU TIDAK HILANG KOK.","MOO, KANDANG BUTUH RESTART.","OTAK MINTA SUSU TAMBAHAN.","TANDUK TAJAM, TIMING BELUM.","SAPI JURI: MOO. ARTINYA COBA LAGI.","BUKAN KALAH, CUMA BALIK KE KANDANG.","SATU PUTARAN LAGI. KAMU BISA!","SALAH HARI INI, JAGO BESOK.","PROGRESMU KELIHATAN, LANJUTKAN!","SKOR BAGUS. REKOR MASIH MENUNGGU.","MOO, KAMU SUDAH JAUH MELANGKAH!"};
inline constexpr uint8_t LossMasks[23]={31,31,31,7,7,7,15,30,7,30,31,7,30,31,31,15,31,31,31,7,30,28,24};
}
