ibnusina339/Remora/firmware/esp32c6/components/remora_ui/src/pixel_ui.cpp

#include "pixel_ui.hpp"
#include "pixel_assets.hpp"
#include "ota_presentation.hpp"
#include "boot_logo.hpp"
#include "esp_heap_caps.h"
#include <algorithm>
#include <cctype>
#include <cstdio>
#include <cstring>
namespace remora {
static uint16_t*fb;static lv_obj_t*canvas;static std::array<uint32_t,30>hashes{};static UiModel*m;static uint32_t bg=0x1c1711,panel=0x30261a,paper=0xf4ebd6,accent=0xffbc68,dim=0xb39a78,lineColor=0x68543c;
static uint16_t rgb(uint32_t c){int r=(c>>16)&255,g=(c>>8)&255,b=c&255,level=m?m->prefs->brightness:100;r=r*level/100;g=g*level/100;b=b*level/100;return ((r>>3)<<11)|((g>>2)<<5)|(b>>3);}
static void rect(int x,int y,int w,int h,uint32_t c){int x0=std::clamp(x,0,320),y0=std::clamp(y,0,240),x1=std::clamp(x+w,0,320),y1=std::clamp(y+h,0,240);auto color=rgb(c);for(int yy=y0;yy<y1;yy++)std::fill(fb+yy*320+x0,fb+yy*320+x1,color);}
static void frame(int x,int y,int w,int h,uint32_t c,int t=1){rect(x,y,w,t,c);rect(x,y+h-t,w,t,c);rect(x,y,t,h,c);rect(x+w-t,y,t,h,c);}
static const Glyph*glyph(char c){c=std::toupper((unsigned char)c);for(const auto&g:Font)if(g.c==c)return &g;return nullptr;}
static int width(const std::string&s,int k){int n=0;for(char c:s){auto g=glyph(c);n+=(g?g->w:3)+1;}return std::max(0,n-1)*k;}
static void text(const std::string&s,int x,int y,int k=1,uint32_t c=0xf4ebd6,int align=0){if(align==1)x-=width(s,k)/2;if(align==2)x-=width(s,k);for(char ch:s){auto g=glyph(ch);if(g)for(int yy=0;yy<7;yy++)for(int xx=0;xx<g->w;xx++)if(g->rows[yy]&(1<<(g->w-1-xx)))rect(x+xx*k,y+yy*k,k,k,c);x+=((g?g->w:3)+1)*k;}}
// Small UI text grows from seven to nine pixels without LCD filtering.
static void smallText(const std::string&s,int x,int y,uint32_t c=0xf4ebd6,int align=0,int maxWidth=300,int height=9){
 int units=width(s,1);if(!units)return;float sx=std::min(1.2f*height/9,float(maxWidth)/units);int w=std::lround(units*sx);if(align==1)x-=w/2;else if(align==2)x-=w;int cursor=0;
 for(char ch:s){auto g=glyph(ch);if(g)for(int yy=0;yy<7;yy++)for(int xx=0;xx<g->w;xx++)if(g->rows[yy]&(1<<(g->w-1-xx))){int left=std::lround((cursor+xx)*sx),right=std::lround((cursor+xx+1)*sx),top=std::lround(float(yy*height)/7),bottom=std::lround(float((yy+1)*height)/7);rect(x+left,y+top,right-left,bottom-top,c);}cursor+=(g?g->w:3)+1;}
}
static void chargingBolt(int x,int y){const char*rows[]={"....####","...####.","..####..",".####...","#######.","...####.","...###..","..###...","..##....",".##.....",".#......","#......."};for(int yy=0;yy<12;yy++)for(int xx=0;xx<8;xx++)if(rows[yy][xx]=='#')rect(x+xx,y+yy,1,1,accent);}
static void sprite(const Sprite&a,int cx,int bottom,int limit=104,bool mirror=false){float scale=std::min(float(limit)/a.w,float(limit)/a.h);if(limit>=166)scale=1;int w=std::lround(a.w*scale),h=std::lround(a.h*scale),left=cx-w/2;for(int y=0;y<h;y++)for(int x=0;x<w;x++){int sx=std::min(a.w-1,int(x/scale));if(mirror)sx=a.w-1-sx;int pos=std::min(a.h-1,int(y/scale))*a.w+sx,v=(a.data[pos/4]>>((pos%4)*2))&3;if(v)rect(left+x,bottom-h+y,1,1,v==1?0x090b0d:v==2?paper:0x999999);}}
static std::string number(int n){return std::to_string(n);}
static void header(const std::string&s="REMORA"){smallText(s,10,9,accent,0);smallText(number(m->battery.percent)+"%",m->usb?259:273,8,paper,2,45,11);if(m->usb)chargingBolt(267,7);frame(280,6,27,15,accent);rect(308,10,3,7,accent);rect(283,9,21*m->battery.percent/100,9,accent);rect(10,25,300,1,lineColor);}
static void footer(std::array<const char*,6>labels,const uint32_t*palette=KeyColors){m->nav.fill(0);rect(0,208,320,32,bg);rect(10,208,300,1,lineColor);for(int i=0;i<6;i++)if(labels[i]){int x=10+i%3*102,y=213+i/3*14;m->nav[i]=palette[i];rect(x,y,11,11,palette[i]);smallText(labels[i],x+16,y+2,palette[i],0,76);}}
static void list(const char*title,const std::vector<std::string>&items){header(title);int first=std::min(std::max(0,m->selection-1),std::max(0,int(items.size())-4));for(int i=0;i<4&&first+i<int(items.size());i++){bool selected=first+i==m->selection;rect(11,39+i*40,298,35,selected?accent:panel);text(items[first+i],23,50+i*40,2,selected?0x090b0d:paper);}footer({nullptr,"UP",nullptr,"BACK","DOWN","OPEN"});}
static std::vector<std::string>wrap(const std::string&s,int limit=23){std::vector<std::string>rows;size_t start=0;while(start<s.size()){auto end=std::min(s.size(),start+size_t(limit));if(end<s.size()){auto space=s.rfind(' ',end);if(space!=s.npos&&space>start)end=space;}rows.push_back(s.substr(start,end-start));start=end;while(start<s.size()&&s[start]==' ')start++;}return rows;}
static void pad(int n,uint32_t color){int x=22+(n%3)*94,y=76+(n/3)*48;frame(x,y,88,40,color?color:lineColor,2);if(color)rect(x+4,y+4,80,32,color);}
static void cowSnakeHead(int x,int y,int k=1){const char*rows[]={"..#......#..",".#o#....#o#.",".#oo####oo#.","##oooooooo##","#oo#oooo#oo#",".#oooooooo#.",".#o#oooo#o#.","..########..",".#oooooooo#.",".#oo#oo#oo#.","..#oooooo#..","...######..."};for(int yy=0;yy<12;yy++)for(int xx=0;xx<12;xx++)if(rows[yy][xx]!='.')rect(x+xx*k,y+yy*k,k,k,rows[yy][xx]=='#'?0x090b0d:paper);}
static void ratingStars(int units,int cx,int y,int k=2){
 const char*rows[]={"......#......",".....###.....",".....###.....","....#####....","#############",".###########.","..#########..","...#######...","...#######...","..####.####..","..###...###..",".##.......##.",".#.........#."};int w=13*k,gap=5*k,left=cx-(5*w+4*gap)/2;
 for(int i=0;i<5;i++)for(int yy=0;yy<13;yy++)for(int xx=0;xx<13;xx++)if(rows[yy][xx]=='#'){bool edge=xx==0||xx==12||yy==0||yy==12||rows[yy-1][xx]!='#'||rows[yy+1][xx]!='#'||rows[yy][xx-1]!='#'||rows[yy][xx+1]!='#',fill=units>=i*2+2||(units==i*2+1&&xx<7);if(edge||fill)rect(left+i*(w+gap)+xx*k,y+yy*k,k,k,fill?accent:lineColor);}
}
static void ratingView(){
 if(m->view==View::RateInvite){header("RATE GAME?");smallText(GameNames[m->rateInviteMode],160,43,dim,1);ratingStars(0,160,64,1);text("TOLONG BERI RATE",160,99,2,paper,1);text("GAME INI",160,121,2,paper,1);smallText("MASUKANMU BANTU REMORA",160,162,dim,1);smallText("BOLEH LEWATI DAN MAIN LAGI",160,186,dim,1);footer({nullptr,nullptr,nullptr,"NANTI",nullptr,"BERI RATE"});return;}
 if(m->view==View::RatePromptSettings){header("RATING PROMPT");text(m->prefs->ratingPrompt.enabled?"ON":"OFF",160,100,4,accent,1);smallText("BERLAKU UNTUK SEMUA PEMAIN",160,161,dim,1);footer({"OFF",nullptr,"ON","BACK",nullptr,"BACK"});return;}
 if(m->view==View::DevGate){header("XDAXA");sprite(cat_sit,160,112,70);text("AKSES DEVELOPER",160,134,2,paper,1);smallText("MASUKKAN KODE AKSES",160,169,dim,1);footer({nullptr,nullptr,nullptr,"BACK"});}
 else if(m->view==View::RateMenu)list("RATE ME",{"RATE GAME","RATE REMORA"});
 else if(m->view==View::RateGames){std::vector<std::string>games;for(auto name:GameNames)games.push_back(name);list("PILIH GAME",games);}
 else if(m->view==View::RatingStars){header(m->rateKind<0?"RATE REMORA":"RATE GAME");smallText(m->rateKind<0?"ASPEK "+number(m->rateStep+1)+" / 5":GameNames[m->rateKind],160,35,dim,1);rect(12,51,296,147,panel);auto rows=wrap(m->rateKind<0?RatingQuestions[m->rateStep]:"SEBERAPA SERU GAME INI?");for(size_t i=0;i<rows.size();i++)text(rows[i],160,65+i*18,2,paper,1);int n=m->rateStars[m->rateStep];ratingStars(n,160,112);text(n?number(n/2)+(n%2?".5":".0")+" / 5":"BELUM DIISI",160,150,2,n?accent:dim,1);smallText(m->status.empty()?"MINIMAL 0.5 / MAKSIMAL 5 BINTANG":m->status,160,183,m->status.empty()?dim:0xff797d,1);footer({"- 0.5",nullptr,"+ 0.5","BACK",nullptr,"LANJUT"});}
 else if(m->view==View::RatingSuggestions){header("SARAN / "+number(__builtin_popcount(m->rateTips))+" DARI 2");int first=std::min(std::max(0,m->selection-1),3);for(int i=0;i<4;i++){int index=first+i,y=39+i*38;bool selected=index==m->selection;rect(12,y,296,34,selected?accent:panel);frame(21,y+10,13,13,selected?0x090b0d:lineColor);if(m->rateTips&(1<<index))rect(24,y+13,7,7,selected?0x090b0d:paper);smallText(RatingSuggestions[index],43,y+12,selected?0x090b0d:paper,0,251);}smallText(m->status.empty()?"OPSIONAL / PILIH MAKSIMAL DUA":m->status,160,196,m->status.empty()?dim:0xff797d,1);footer({nullptr,"UP","SIMPAN","BACK","DOWN","PILIH"});}
 else if(m->view==View::RatingThanks){header("RATE ME");ratingStars(10,160,42,1);const char*rows[]={"TERIMAKASIH SUDAH","KASIH RATING BUAT REMORA,","SEGALA MASUKAN","SANGAT BERARTI"};for(int i=0;i<4;i++)text(rows[i],160,82+i*24,2,paper,1);footer({nullptr,nullptr,nullptr,"BACK",nullptr,"SELESAI"});}
 else if(m->view==View::RateResults)list("HASIL RATING",{"RATING GAME","RATING REMORA"});
 else if(m->view==View::RateArchive){if(m->ratingRecords.empty()){header("HASIL RATING");text("BELUM ADA RATING",160,101,2,dim,1);footer({nullptr,nullptr,nullptr,"BACK"});}else{std::vector<std::string>rows;for(auto&r:m->ratingRecords)rows.push_back("RATE "+number(r.id)+" / "+r.name);list(m->rateFilter==0?"RATING GAME":"RATING REMORA",rows);}}
 else if(m->view==View::RateReport){header("HASIL RATING");for(int i=0;i<5&&m->rateScroll+i<int(m->rateReportRows.size());i++){auto&row=m->rateReportRows[m->rateScroll+i];int y=43+i*31;if(row.rfind("STARS:",0)==0){int n=atoi(row.c_str()+6);ratingStars(n,105,y,1);smallText(number(n/2)+(n%2?".5":".0")+" / 5",180,y+2,accent);}else smallText(row,18,y+4,paper,0,282);}int length=m->rateReportRows.size();frame(309,40,3,154,lineColor);rect(309,40+(m->rateScroll*134/std::max(1,length-5)),3,20,accent);footer({nullptr,"UP",nullptr,"BACK","DOWN"});}
}

static void scene(){int g=m->game;if(g==GameCount){ratingStars(10,104,112);sprite(cow_happy,254,190,78);smallText("SUARAMU BERARTI",104,162,dim,1);return;}rect(16,199,288,1,lineColor);const Sprite*poses[]={&cow_stand,&cow_back,&cow_alert,&cow_graze,&cow_jump,&cow_run,&cow_roll,&cow_peek,&cow_listen,&cow_snake,&cow_pingpong};sprite(*poses[g],250,196);rect(16,81,164,105,panel);if(g==0||g==1||g==4||g==7){int phase=(m->now/400)%6;for(int i=0;i<6;i++){int x=25+i%3*49,y=91+i/3*46;frame(x,y,40,36,lineColor);if((g==1?5-phase:phase)==i)rect(x+2,y+2,36,32,KeyColors[i]);}}else if(g==3){for(int i=0;i<6;i++){rect(27+i*25,91,2,80,paper);rect(27,91+i*15,140,2,paper);}rect(30,94,12,12,accent);text("G",155,163,2,0x8bdcad);}else if(g==8){text("1011",99,103,4,accent,1);text("= 11",99,154,3,paper,1);}else if(g==9){for(int i=0;i<6;i++){rect(32+i*17,119,17,17,paper);rect(34+i*17,120+(i%2)*8,8,8,0x090b0d);}cowSnakeHead(132,114,2);}else if(g==10){frame(25,86,145,96,accent,2);rect(34,102,6,28,paper);rect(155,136,6,28,paper);for(int y=92;y<180;y+=12)rect(97,y,2,5,dim);rect(60+(m->now/100)%70,120,6,6,paper);}else if(g==2){text("GO!",99,105,4,0x8bdcad,1);}else if(g==5){text("HOT",99,108,4,accent,1);}else{text("< >",99,109,4,accent,1);}}
static void gameplay(){auto&s=m->engine->s;header(GameNames[s.mode]);if(s.phase==Phase::Over||s.phase==Phase::Clear||s.phase==Phase::ReactionResult){text(s.phase==Phase::Over?"GAME OVER":"MOO-NTAP!",160,38,2,accent,1);if(s.phase==Phase::Over)smallText(s.reason,160,60,accent,1);sprite(s.phase==Phase::Over?cow_sad:cow_happy,160,133,65);text(s.mode==2?number(s.elapsed)+" MS":"SCORE "+number(s.score),160,142,2,paper,1);auto lines=wrap(s.message);for(size_t i=0;i<std::min(size_t(2),lines.size());i++)text(lines[i],160,169+i*17,2,paper,1);smallText(s.endMessage,160,198,dim,1);footer({nullptr,nullptr,nullptr,"MENU",nullptr,s.phase==Phase::Clear?nullptr:s.phase==Phase::ReactionResult?"NEXT":"RETRY"});return;}
 auto leds=m->engine->leds();m->nav=leds;
 if(s.mode==2){bool go=s.phase==Phase::ReactionGo,fake=s.phase==Phase::ReactionFake;text(go||fake?"GO!":"WAIT...",160,45,4,go?0x8bdcad:fake?0xff797d:accent,1);sprite(cow_alert,69,165,70);if(go||fake)rect(196,103,25,35,s.palette[s.target-1]);smallText(fake?"JANGAN TEKAN":!go?"TUNGGU GO HIJAU":s.difficulty==4?"TOMBOL SEBELAH":s.difficulty==3?"TOMBOL CERMIN":"WARNA TARGET",210,151,dim,1);}
 else if(s.mode==3){
  std::string mission=s.mazeMission==1?"CARI KUNCI / BUKA GERBANG":s.mazeMission==2?"PANEN SEMUA SUSU":"TEMUKAN GOAL";
  smallText(s.phase==Phase::MazePreview?"INGAT PETA / "+mission:mission,160,32,accent,1);
  int cw=276/s.cols,ch=114/s.rows,left=(320-cw*s.cols)/2,top=45;
  for(int n=0;n<s.cols*s.rows;n++){
   bool known=s.mapVisible||has(s.visited,n)||n==s.current||has(s.links[s.current],n);int x=left+n%s.cols*cw,y=top+n/s.cols*ch;
   rect(x+1,y+1,cw-1,ch-1,has(s.visited,n)?panel:bg);
   if(!known){rect(x+cw/2,y+ch/2,1,1,lineColor);continue;}
   for(int dir=0;dir<4;dir++){
    int dest=n+(int[]){-s.cols,1,s.cols,-1}[dir];if(!has(s.links[n],dest)){if(dir%2)rect(x+(dir==1?cw:0),y,1,ch+1,paper);else rect(x,y+(dir==2?ch:0),cw+1,1,paper);}
   }
   const char*label=n==s.mazeKey&&!s.mazeKeyTaken?"K":n==s.mazeGate&&!s.mazeKeyTaken?"X":n==s.goal?"G":!s.portalUsed&&(n==s.portalFrom||n==s.portalTo)?"P":has(s.bonuses,n)&&!has(s.collected,n)?"*":n==s.start?"S":"";
   uint32_t color=label[0]=='X'?0xff797d:label[0]=='P'?0x79acfa:label[0]=='K'||label[0]=='*'?0xffd76b:0x8bdcad;
   text(label,x+cw/2,y+(ch-7)/2,1,color,1);
  }
  int x=left+s.current%s.cols*cw,y=top+s.current/s.cols*ch;rect(x+3,y+3,cw-5,ch-5,accent);rect(x+cw/2-1,y+ch/2-1,3,3,0x090b0d);
  std::string info=s.mazeKey>=0?(s.mazeKeyTaken?"K OK / ":"K BELUM / "):"";
  info+="SUSU "+number(s.collected.size())+"/"+number(s.bonuses.size());if(s.difficulty>=2)info+=" / SISA "+number(std::max(0,s.moveLimit-s.moves));
  smallText(s.reason.empty()?info:s.reason,160,164,s.reason.empty()?dim:0xffd76b,1);
 }
 else if(s.mode==6){int dir=s.chain.empty()?0:s.chain[s.chainIndex%s.chain.size()];text((const char*[]){"UP","RIGHT","DOWN","LEFT"}[dir],74,100,3,accent,1);smallText("ROT "+number(s.rotation*90)+(s.mirror?" + MIRROR":""),160,37,dim,1);for(int i=0;i<4;i++){int x=153+(i%2)*78,y=72+(i/2)*48;frame(x,y,70,42,lineColor);if(s.difficulty<2||s.phase==Phase::DirectionPreview){rect(x+8,y+8,10,14,s.palette[s.mapping[i]-1]);smallText((const char*[]){"UP","RIGHT","DOWN","LEFT"}[i],x+23,y+10);}}}
 else if(s.mode==8){if(s.phase==Phase::DecoderWatch){text("SIGNAL",160,43,2,accent,1);if(s.bit>=0){rect(110,78,100,62,s.bit?0xffd76b:0x79acfa);text(s.bit?"HIGH":"LOW",160,101,3,0x090b0d,1);}text(number(s.slot+1)+" / "+number(s.bitCount)+" BIT",160,149,2,dim,1);}else{for(int i=0;i<3;i++){frame(47+i*78,68,68,65,i==s.digitIndex?accent:lineColor,2);text(number(s.digits[i]),81+i*78,80,5,paper,1);}footer({"LEFT","PLUS","RIGHT","CLEAR","MINUS","OK"});}}
 else if(s.mode==9){frame(28,41,264,132,lineColor);for(int rock:s.rocks)rect(31+rock%s.cols*10,43+rock/s.cols*10,8,8,dim);for(size_t i=1;i<s.body.size();i++){int n=s.body[i],x=30+n%s.cols*10,y=42+n/s.cols*10;rect(x,y,10,10,paper);rect(x+(i%2)*4,y,5,5,0x090b0d);}cowSnakeHead(29+s.body[0]%s.cols*10,41+s.body[0]/s.cols*10);
 int x=35+s.food%s.cols*10,y=43+s.food/s.cols*10;if(s.goldenFood){rect(x-3,y+2,7,7,0xffd76b);rect(x-1,y,3,3,paper);rect(x-1,y+4,3,3,bg);}else rect(x-2,y+2,5,5,0x8bdcad);
 smallText("RUMPUT "+number(s.eaten)+" / "+number(s.goal),160,29,0x8bdcad,1);
 smallText(s.goldenFood?"SUSU EMAS +90 / "+number((s.foodExpires-s.now+999)/1000)+"s":"RUMPUT +35 / SUSU EMAS +90",160,195,dim,1);
 }
 else if(s.mode==10){frame(16,38,288,132,lineColor);for(int x=22;x<298;x+=12)rect(x,101,5,1,lineColor);if(s.now>=s.milkReadyAt){frame(s.milkTargetX-7,94,15,15,0xffd76b,2);rect(s.milkTargetX-1,98,3,7,paper);}rect(s.aiX-s.aiWidth/2,42,s.aiWidth,6,paper);rect(s.playerX-s.width/2,153,s.width,7,paper);rect(s.bx-3,s.by-3,6,6,paper);smallText("NYAWA "+number(s.lives),303,29,paper,2);smallText("POIN "+number(s.hits)+"/"+number(s.goal),17,29,paper);
 smallText(s.now<s.paddleBoostUntil?"PADDLE +8 / "+number((s.paddleBoostUntil-s.now+999)/1000)+"s":"BIDIK SUSU SAAT BALAS BOLA",160,195,dim,1); }
 else {for(int i=0;i<6;i++)pad(i,leds[i]);if(s.mode==4&&s.difficulty<2){for(auto &c:s.cues)if(!c.done){int x=66+(c.key-1)%3*94,y=102+(c.key-1)/3*48;smallText((const char*[]){"TAP","NO","DOUBLE","HOLD","NEXT"}[c.type],x,y,0x090b0d,1);}}if(s.mode==7&&s.gap)text("?",160,43,3,accent,1);if(s.mode==5)text("TARGET",160,42,2,accent,1);}
 text("LV "+number(s.level),13,178,2,dim);text("S "+number(s.score),306,178,2,paper,2);if(s.deadline){float f=std::clamp(float(s.deadline-s.now)/std::max(int64_t(1),s.window),0.f,1.f);frame(13,197,294,5,lineColor);rect(14,198,292*f,3,f<.25?0xff797d:accent);}if(s.mode==3){std::string scan=s.scanActive?"SCAN...":"SCAN "+number(s.scanCharges);footer({"LEFT","UP","RIGHT",nullptr,"DOWN",s.phase==Phase::MazeInput&&(s.scanCharges>0||s.scanActive)?scan.c_str():nullptr},s.palette.data());m->nav=leds;}else if(s.mode==9)footer({nullptr,"UP",nullptr,"LEFT","DOWN","RIGHT"},s.palette.data());else if(s.mode==10)footer({"LEFT",nullptr,"RIGHT"},s.palette.data());else if(!(s.mode==8&&s.phase==Phase::DecoderInput))smallText(s.mode==4&&s.difficulty>=2?"":"TAHAN KIRI BAWAH 2S: KELUAR",160,223,dim,1);
}
std::string tutorialMessage(int step,const std::string& name){
 const std::string messages[]={"HAI "+name+"! AYO KENAL REMORA. TEKAN HIJAU.","INI CLASSIC. HAFALKAN LAMPU! TEKAN CYAN UNTUK INFO.","INFO BERISI CARA MAIN. UNGU/KUNING PINDAH HALAMAN. HIJAU: LANJUT.","UNGU: LEBIH MUDAH. KUNING: LEBIH SULIT. COBA TEKAN KUNING.","DIFFICULTY TERSIMPAN, "+name+". TUTUP PESAN UNTUK MELIHATNYA.","INI SETTINGS UNTUK SUARA, LAYAR, DAN PROFILMU, "+name+".","SIAP, "+name+"! TAHAN TOMBOL KIRI BAWAH 2 DETIK UNTUK KELUAR GAME."};
 return messages[std::clamp(step,0,6)];
}
void uiInit(){fb=(uint16_t*)heap_caps_malloc(320*240*2,MALLOC_CAP_INTERNAL|MALLOC_CAP_8BIT);assert(fb);canvas=lv_canvas_create(lv_screen_active());lv_obj_remove_style_all(canvas);lv_canvas_set_buffer(canvas,fb,320,240,LV_COLOR_FORMAT_RGB565);lv_obj_set_pos(canvas,0,0);lv_obj_set_size(canvas,320,240);lv_obj_remove_flag(canvas,LV_OBJ_FLAG_SCROLLABLE);uiInvalidate();}
void uiInvalidate(){hashes.fill(0);if(canvas)lv_obj_invalidate(canvas);}
void uiDraw(UiModel&model,bool force){m=&model;bg=m->prefs->mono?0x101010:m->prefs->ocean?0x101c26:0x1c1711;panel=m->prefs->mono?0x242424:m->prefs->ocean?0x1a2e3b:0x30261a;accent=m->prefs->mono?0xffffff:m->prefs->ocean?0x9dd3e8:0xffbc68;paper=m->prefs->mono?0xf5f5f5:0xf4ebd6;dim=m->prefs->mono?0xb8b8b8:m->prefs->ocean?0x9fb9ca:0xb39a78;lineColor=m->prefs->mono?0x626262:m->prefs->ocean?0x415f71:0x68543c;rect(0,0,320,240,bg);m->nav.fill(0);auto&p=*m->prefs;
 if(m->view==View::Boot){float f=std::clamp(float(m->now-m->animationStart)/550,0.f,1.f);if(m->now-m->animationStart>1850)f=std::clamp(float(2400-(m->now-m->animationStart))/550,0.f,1.f);int pos=0;for(auto run:BootLogo){auto v=run.rgba;float alpha=(v&15)/15.f*f;uint32_t color=(uint32_t(((v>>12)&15)*17*alpha+((bg>>16)&255)*(1-alpha))<<16)|(uint32_t(((v>>8)&15)*17*alpha+((bg>>8)&255)*(1-alpha))<<8)|uint32_t(((v>>4)&15)*17*alpha+(bg&255)*(1-alpha));if(alpha>0){for(int i=0;i<run.count;i++)fb[pos+i]=rgb(color);}pos+=run.count;}}

 else if(m->view==View::ConfirmShutdown){header("MATIKAN REMORA?");sprite(cow_sleep,160,136,90);text("ISTIRAHAT DULU?",160,157,2,paper,1);smallText("HIJAU MATIKAN / MERAH BATAL",160,184,dim,1);footer({nullptr,nullptr,nullptr,"BATAL",nullptr,"MATIKAN"});}
 else if(m->view==View::Shutdown){sprite(cow_sleep,160,155,124);sprite(cat_sleep,145,94,53);text("SAMPAI MOO-LAGI!",160,175,2,paper,1);}
 else if(m->view==View::Notice){header();bool low=m->power==PowerPhase::LowNotice,lock=m->power==PowerPhase::ChargeNotice;if(low){frame(35,80,88,53,accent,3);rect(124,96,7,21,accent);if(m->usb){rect(80,87,10,19,accent);rect(72,105,10,20,accent);}else{for(int i=0;i<26;i++){rect(64+i,93+i,4,4,accent);rect(64+i,119-i,4,4,accent);}}sprite(cow_sleep,223,150,100);text("PULIH MINIMAL 10%",160,174,2,accent,1);}else{text(lock?"CABUT USB":"USB TERHUBUNG",160,43,2,accent,1);text(number(m->battery.percent)+"%",160,99,5,paper,1);text(low?"PULIH MINIMAL 10%":lock?"GAME TERKUNCI 80%":"ESTIMASI BATERAI",160,165,2,dim,1);}smallText(m->power==PowerPhase::BatteryPeek?"TAMPIL 5 DETIK":"KEMBALI STANDBY",160,192,dim,1);}
 else if(m->view==View::Home){header();text(m->game==GameCount+1?"SETTINGS":m->game==GameCount?"RATE ME":GameNames[m->game],160,39,3,paper,1);if(m->game==GameCount+1){sprite(cow_drink,85,196);frame(160,85,140,100,lineColor);for(int i=0;i<3;i++){rect(175,100+i*28,110,2,dim);rect(190+i*25,95+i*28,7,12,accent);}}else scene();footer({"PREV",m->game<GameCount?"INFO":nullptr,"NEXT",nullptr,nullptr,m->game<GameCount?"PLAY":"OPEN"});}
 else if(m->view==View::Pregame){header("");text(GameNames[m->game],14,39,2,paper);frame(11,83,182,59,accent,2);text((const char*[]){"EASY","NORMAL","HARD","EXPERT","MASTER"}[p.difficulty[m->game]],102,100,2,accent,1);const Sprite*poses[]={&cow_easy,&cow_normal,&cow_hard,&cow_expert,&cow_master};sprite(*poses[p.difficulty[m->game]],252,153,96);text("TOP SCORE",16,179,2,dim);int n=p.records[m->game][p.difficulty[m->game]];text(n<0?"--":number(n),303,179,2,paper,2);footer({"EASIER",nullptr,"HARDER","BACK",nullptr,"START"});}
 else if(m->view==View::Guide){header("GAME GUIDE");text(GameNames[m->game],27,36,2,paper);std::vector<std::string>lines;for(auto src:Guides[m->game]){if(!src)break;auto rows=wrap(src);lines.insert(lines.end(),rows.begin(),rows.end());lines.push_back("");}if(!lines.empty())lines.pop_back();m->guidePages=std::max(1,int((lines.size()+6)/7));m->guidePage=std::clamp(m->guidePage,0,m->guidePages-1);rect(11,59,298,142,panel);for(int i=0;i<7&&m->guidePage*7+i<int(lines.size());i++)text(lines[m->guidePage*7+i],20,66+i*19,2,paper);if(m->game==m->peekGame)sprite(cat_peek,m->peekSide?322:-2,56,31,m->peekSide);footer({m->guidePage?"PREV":nullptr,nullptr,m->guidePage+1<m->guidePages?"NEXT":nullptr,"BACK",nullptr,"PLAY"});}
 else if(m->view==View::Playing)gameplay();
 else if(m->view==View::DevGate||(m->view>=View::RateMenu&&m->view<=View::RatePromptSettings))ratingView();
 else if(m->view==View::Settings){std::vector<std::string>rows={"SOUND","DISPLAY","THEME","KEY LIGHT","BATTERY","PROFILE","NETWORK","SYSTEM","STATS","FIRST LOGIN","AUTO OFF","STANDBY"};if(p.active==DeveloperSlot&&m->developerUnlocked)rows.push_back("RATING PROMPT");list("SETTINGS",rows);}
 else if(m->view==View::AutoOff){header("AUTO OFF");int minutes=validAutoOff(p.autoOffMinutes);frame(11,76,298,75,accent,2);text(minutes?number(minutes)+" MENIT":"NONAKTIF",160,99,4,paper,1);smallText(minutes?"MATI SETELAH TANPA INPUT":"AUTO OFF DINONAKTIFKAN",160,168,dim,1);smallText("TERSIMPAN DI PROFIL INI",160,188,dim,1);footer({"LESS",nullptr,"MORE","BACK",nullptr,"OK"});}
 else if(m->view==View::Sound){header("SOUND MIXER");int values[]={p.master,p.bgm,p.sfx};for(int i=0;i<3;i++){int y=37+i*51;rect(11,y,298,45,panel);if(m->soundRow==i)frame(11,y,298,45,accent,2);text((const char*[]){"UTAMA","BGM MENU","SFX"}[i],22,y+7,2,paper);smallText(number(values[i])+"%",298,y+9,paper,2);frame(22,y+27,276,9,lineColor);rect(24,y+29,272*values[i]/100,5,accent);}footer({"VOL -","UP","VOL +","BACK","DOWN","BACK"});}
 else if(m->view==View::Display){header("DISPLAY");text("KECERAHAN",15,46,2,m->displayRow?paper:accent);text(number(p.brightness)+"%",302,71,3,paper,2);text("SPI CLOCK",15,114,2,m->displayRow?accent:paper);text(number(displayClock())+" MHZ",302,140,3,paper,2);char stats[40];snprintf(stats,sizeof(stats),"FPS %.1F / ERROR %lu",displayFps(),(unsigned long)displayErrors());smallText(stats,160,177,dim,1);smallText(p.spiPending?"KONFIRMASI "+number(std::max(int64_t(0),(m->spiDeadline-m->now)/1000))+"S / AUTO 10 MHZ":"SPI CEPAT: UJI KABEL PENDEK",160,193,dim,1);footer(p.spiPending?std::array<const char*,6>{nullptr,nullptr,nullptr,"RESET",nullptr,"STABIL"}:std::array<const char*,6>{"LESS","UP","MORE","BACK","DOWN",nullptr});}
 else if(m->view==View::WifiScan){header("WIFI");auto nets=networkScanResults();if(networkScanning())text("MEMINDAI...",160,101,2,accent,1);else if(nets.empty()){auto rows=wrap(networkScanMessage());for(size_t i=0;i<rows.size();i++)text(rows[i],160,95+i*18,2,dim,1);}else{m->selection=std::clamp(m->selection,0,int(nets.size())-1);int first=std::max(0,m->selection-2);for(int i=0;i<4&&first+i<int(nets.size());i++){auto&n=nets[first+i];int y=39+i*40;bool selected=first+i==m->selection;rect(11,y,298,36,selected?accent:panel);text(n.ssid.substr(0,21),22,y+5,2,selected?0x090b0d:paper);smallText(std::string(n.secured?"TERKUNCI":"TANPA PASSWORD")+" / "+number(n.rssi)+" DBM",22,y+24,selected?0x090b0d:dim,0);}}footer({networkScanning()?nullptr:"SCAN",nets.empty()?nullptr:"UP",nullptr,"BACK",nets.empty()?nullptr:"DOWN",nets.empty()?nullptr:"CONNECT"});}
 else if(m->view==View::Network)list("NETWORK",{"SCAN WIFI","PHONE SETUP","CONNECT SAVED","WIFI STATUS","OTA UPDATE"});
 else if(m->view==View::Portal){header("PHONE SETUP");text("REMORA-SETUP",160,65,3,accent,1);text("PASS "+portalPassword(),160,114,2,paper,1);text("192.168.4.1",160,153,3,paper,1);footer({nullptr,nullptr,nullptr,"BACK"});}
 else if(m->view==View::Ota){
  header("GITHUB OTA");auto o=otaStatus();text("VERSI "+o.version,15,49,2,accent);
  auto presentation=otaPresentation(o.busy,o.available,o.version,o.message);
  if(presentation==OtaPresentation::Ready){
   auto version=otaVersionLabel(o.version);
   text("READY TO UPDATE TO",160,89,2,paper,1);text(version+" VERSION",160,116,2,accent,1);
   smallText("HIJAU PASANG / MERAH KEMBALI",160,154,dim,1);
  }else if(presentation==OtaPresentation::Latest){text("LATEST FIRMWARE",160,101,2,paper,1);smallText("TIDAK ADA VERSI LEBIH BARU",160,143,dim,1);}
  else {auto lines=wrap(o.message);for(size_t i=0;i<std::min(size_t(4),lines.size());i++)text(lines[i],15,84+i*20,2,paper);}
  if(o.busy||o.progress>0){frame(15,177,290,10,lineColor);rect(17,179,286*o.progress/100,6,accent);}
  footer({nullptr,nullptr,nullptr,o.busy?"CANCEL":"BACK",nullptr,o.busy?nullptr:o.available?"INSTALL":"CHECK"});
 }
 else if(m->view==View::Profiles){std::vector<std::string>names;for(int i=0;i<ProfileCount;i++)names.push_back(p.profiles[i].used?std::string(i==p.active?"> ":"  ")+p.profiles[i].player:"+ ADD PLAYER");list("PLAYER PROFILE",names);}
 else if(m->view==View::ProfileAction){list("PLAYER",{"SWITCH USER","EDIT NAME","DELETE USER"});}
 else if(m->view==View::ConfirmDelete||m->view==View::ConfirmFirst){header("KONFIRMASI");text(m->view==View::ConfirmDelete?"HAPUS PEMAIN INI?":"FIRST LOGIN?",160,67,2,accent,1);smallText(m->view==View::ConfirmDelete?"DATA PEMAIN AKAN DIHAPUS":"BUAT PEMAIN BARU SAAT NYALA",160,119,paper,1);smallText(m->view==View::ConfirmFirst?"PROFIL LAIN TETAP TERSIMPAN":"TIDAK BISA DIBATALKAN",160,148,dim,1);footer({nullptr,nullptr,nullptr,"BATAL",nullptr,"YA"});}
 else if(m->view==View::SlotsFull){header("SLOT PENUH");text("LIMA PEMAIN TERSIMPAN",160,69,2,accent,1);smallText("HAPUS SATU PROFIL DAHULU",160,115,paper,1);smallText("LALU PILIH FIRST LOGIN LAGI",160,145,dim,1);footer({nullptr,nullptr,nullptr,"BATAL",nullptr,"PROFILES"});}
 else if(m->view==View::FirstCountdown){header("FIRST LOGIN");text("TERSIMPAN",160,63,2,accent,1);text(number(std::max(int64_t(0),3-(m->now-m->animationStart)/1000)),160,105,5,paper,1);text("REMORA AKAN MATI",160,168,2,dim,1);}
 else if(m->view==View::Profile){header("PLAYER PROFILE");sprite(cat_groom,160,111,82);text(p.player,160,123,3,paper,1);footer({nullptr,nullptr,nullptr,"BACK",nullptr,"EDIT"});}
 else if(m->view==View::Name||m->view==View::Text){header(m->entryTitle);text(m->password&&!m->showPassword?std::string(m->entry.size(),'*'):m->entry,160,70,2,paper,1);text("CHAR",65,128,2,dim);text(std::string(1,(const char*[]){"ABCDEFGHIJKLMNOPQRSTUVWXYZ ","abcdefghijklmnopqrstuvwxyz ","0123456789","!@#$%^&*()-_=+.,?/"}[m->charGroup][m->charIndex]),180,117,5,accent,1);if(m->view==View::Text&&!m->status.empty())smallText(m->status,160,157,0xff797d,1);smallText("HIJAU TAHAN: SIMPAN",160,m->canCancelName?174:184,dim,1);if(m->canCancelName)smallText("TAHAN MERAH 1 DETIK: BATAL",160,192,dim,1);footer({"GROUP-","PREV","GROUP+",m->canCancelName&&m->entry.empty()?"BATAL":m->view==View::Text&&m->wifiFromScan&&m->entry.empty()?"BACK":"DELETE","NEXT","ADD"});}
 else if(m->view==View::Stats){header("ACHIEVEMENTS");sprite(cat_happy,126,82,50);text("GAMES",15,60,2,dim);text(number(p.games),303,85,3,paper,2);int best=0;for(int i=0;i<GameCount;i++)if(i!=2)for(int d=0;d<5;d++)best=std::max(best,p.records[i][d]);text("BEST SCORE",15,132,2,dim);text(number(best),303,160,3,paper,2);footer({nullptr,nullptr,nullptr,"BACK"});}
 else if(m->view==View::Secret){header("RAHASIA");smallText("MEOW... BUKAN MOO!",160,33,paper,1);sprite(cat_secretStand,160,196,166);footer({nullptr,nullptr,nullptr,"BACK",nullptr,"MEOW"});}
 else if(m->view==View::System)list("SYSTEM",{"DIAGNOSTICS","BUTTON TEST","LED TEST","SPEAKER TEST","DISPLAY TEST"});
 else if(m->view==View::DisplayTest){header("DISPLAY TEST");for(int i=0;i<6;i++)rect(12+i*50,49,46,112,KeyColors[i]);footer({nullptr,nullptr,nullptr,"BACK"});}
 else if(m->view==View::ButtonTest||m->view==View::SpeakerTest||m->view==View::LedTest){header("HARDWARE TEST");for(int i=0;i<6;i++)pad(i,m->testKey==i+1?KeyColors[i]:0);footer({nullptr,nullptr,nullptr,"BACK"});}
 else {header(m->entryTitle);auto lines=wrap(m->status);for(size_t i=0;i<std::min(size_t(7),lines.size());i++)text(lines[i],16,43+i*22,2,paper);footer({"LESS",nullptr,"MORE","BACK",nullptr,"SAVE"});}
 if(m->tutorial>=0&&m->view!=View::ConfirmShutdown&&m->view!=View::Shutdown){
   std::string message=tutorialMessage(m->tutorial,p.player);size_t shown=m->tutorialReveal?message.size():std::min(message.size(),size_t(std::max(int64_t(0),m->now-m->tutorialAt)/30));
   if(m->tutorialDialog){int limit=27;auto lines=wrap(message,limit);while(limit>12&&std::any_of(lines.begin(),lines.end(),[](const auto&s){return width(s,2)>258;}))lines=wrap(message,--limit);frame(16,140,288,64,accent,2);rect(18,142,284,60,panel);sprite(cat_sit,42,140,34);size_t offset=0;int top=172-(int(lines.size())*16-2)/2;for(size_t i=0;i<lines.size();i++){int visible=std::clamp(int(shown)-int(offset),0,int(lines[i].size()));if(visible)text(lines[i].substr(0,visible),160-width(lines[i],2)/2,top+i*16,2,paper);offset+=lines[i].size()+1;}footer({nullptr,nullptr,nullptr,nullptr,nullptr,shown<message.size()?"TEXT":m->tutorial==0||m->tutorial==6?"LANJUT":"TUTUP"});}
   else footer({m->tutorial==2&&m->guidePage?"PREV":nullptr,m->tutorial==1?"INFO":m->tutorial==5?"UP":nullptr,m->tutorial==3?"HARDER":m->tutorial==2&&m->guidePage+1<m->guidePages?"NEXT":nullptr,nullptr,m->tutorial==5?"DOWN":nullptr,m->tutorial==4?"SETTINGS":m->tutorial==2||m->tutorial==5?"LANJUT":nullptr});
 }
 if(m->exitStarted>=0&&m->now-m->exitStarted>=500){rect(32,88,256,56,panel);frame(32,88,256,56,0xff797d,2);text("TAHAN UNTUK KELUAR",160,101,2,paper,1);frame(44,125,232,8,lineColor);rect(46,127,228*std::min(int64_t(2000),m->now-m->exitStarted)/2000,4,0xff797d);}
 if(m->view==View::Shutdown){float t=std::max(0.f,float(m->now-m->animationStart-1100)/1400);t=std::min(1.f,t);for(int i=0;i<320*240;i++){auto c=fb[i];fb[i]=(uint16_t(((c>>11)&31)*(1-t))<<11)|(uint16_t(((c>>5)&63)*(1-t))<<5)|uint16_t((c&31)*(1-t));}if(m->now-m->animationStart>1800){int h=std::max(1,int(240*(2500-(m->now-m->animationStart))/700));rect(0,0,320,(240-h)/2,0);rect(0,(240+h)/2,320,(240-h)/2,0);rect(160-int(150*(1-t)),119,int(300*(1-t)),1,paper);}}
 for(int band=0;band<30;band++){uint32_t h=2166136261;for(int i=band*320*8;i<(band+1)*320*8;i++)h=(h^fb[i])*16777619;if(force||h!=hashes[band]){hashes[band]=h;lv_area_t a={0,band*8,319,band*8+7};lv_obj_invalidate_area(canvas,&a);}}
}
}
