ibnusina339/Remora/firmware/esp32c6/components/remora_ui/include/pixel_assets.hpp

#pragma once
#include <cstdint>
namespace remora {
struct Sprite {int w,h;const uint8_t*data;};
inline constexpr uint8_t cow_stand_data[]={0,0,0,0,0,0,0,0,0,0,0,0,0,0,0,0,0,0,64,85,21,0,0,0,0,0,0,0,0,0,0,0,0,0,0,0,0,0,0,0,0,0,0,0,80,85,21,0,0,0,0,0,0,0,0,0,0,0,80,85,0,0,0,0,0,0,0,0,0,0,80,85,85,1,0,0,0,0,0,0,0,0,0,0,80,85,1,0,0,0,0,0,0,0,0,0,80,85,85,1,0,0,0,0,0,0,0,0,0,0,80,85,1,0,0,0,0,0,0,0,0,0,80,149,85,1,0,0,0,0,0,0,0,0,0,0,85,85,1,0,0,0,0,0,0,0,0,0,80,149,106,85,0,0,0,0,0,0,0,0,0,0,85,85,1,0,0,0,0,0,0,0,0,0,80,149,106,85,0,0,0,0,0,0,0,0,0,80,165,90,1,0,0,0,0,0,0,0,0,0,80,149,170,90,5,0,0,0,0,0,0,0,0,80,165,90,1,0,0,0,0,0,0,0,0,0,80,149,170,86,5,0,0,0,0,0,0,0,0,85,170,90,85,0,0,0,0,0,0,0,0,0,85,149,170,86,5,0,0,0,0,0,0,0,0,85,170,90,85,0,0,0,0,0,0,0,0,0,85,149,170,90,5,0,0,0,0,0,0,0,0,85,170,170,85,5,0,85,85,85,85,85,5,80,85,169,170,90,5,0,0,0,0,0,0,0,0,85,170,170,85,5,64,85,85,85,85,85,85,85,85,169,170,86,5,0,0,0,0,0,0,0,0,85,170,170,85,85,85,85,85,85,85,85,85,85,85,170,170,86,5,0,0,0,0,0,0,0,0,85,170,170,86,85,85,85,85,85,85,85,85,85,169,170,170,86,5,0,0,0,0,0,0,0,0,85,170,170,170,85,85,85,85,85,85,85,85,85,170,170,170,86,5,0,0,0,0,0,0,0,0,85,170,170,170,85,85,85,85,85,85,85,85,85,170,170,170,86,5,0,0,0,0,0,0,0,0,85,170,170,170,85,85,85,85,85,85,85,85,85,170,170,170,90,5,0,0,0,0,0,0,0,0,85,165,170,170,85,85,85,85,85,85,165,170,90,149,170,106,85,5,0,0,0,0,0,0,0,0,85,165,170,170,85,85,85,85,85,85,165,170,90,149,170,106,85,5,0,0,0,0,0,0,0,0,84,165,170,90,85,85,85,85,85,85,165,170,170,85,169,90,85,0,0,0,0,0,0,0,0,0,84,85,170,90,85,85,85,85,85,85,165,170,170,85,169,86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
0,0,0,0,64,85,85,85,85,5,0,0,0,0,0,0,64,85,169,85,85,85,5,0,0,0,0,0,0,0,0,0,64,85,85,85,85,5,0,0,0,0,0,0,64,85,165,85,85,85,5,0,0,0,0,0,0,0,0,0,0,84,85,85,85,0,0,0,0,0,0,0,0,80,85,85,85,85,5,0,0,0,0,0,0,0,0,0,0,80,85,85,5,0,0,0,0,0,0,0,0,0,85,85,85,85,1,0,0,0,0,0,0,0,0,0,0,80,85,85,5,0,0,0,0,0,0,0,0,0,85,85,85,85,1,0,0,0,0,0,0,0,0,0,0,0,85,85,0,0,0,0,0,0,0,0,0,0,64,85,85,85,1,0,0,0,0,0,0,0,0,0,0,0,85,85,0,0,0,0,0,0,0,0,0,0,64,85,85,21,0,0,0,0,0,0,0,0,0,0,0,0,0,0,0,0,0,0,0,0,0,0,0,0,0,85,85,5,0,0,0,0,0,0,0};
inline constexpr Sprite cow_run={112,81,cow_run_data};
inline constexpr uint8_t cow_roll_data[]={0,0,0,0,0,0,0,84,1,0,0,0,0,0,0,0,0,0,0,0,0,0,0,0,0,0,0,0,0,0,0,0,0,84,21,0,0,0,0,0,0,0,0,0,0,0,0,0,0,0,0,0,0,0,0,0,0,0,0,84,85,0,0,0,0,0,0,0,0,80,85,1,0,0,0,0,0,0,0,0,0,0,0,0,0,80,85,0,0,0,0,0,0,0,0,0,85,21,0,0,0,0,0,0,0,0,0,0,0,0,0,64,85,0,0,0,0,0,0,0,0,0,85,85,21,0,0,0,0,0,0,0,0,0,0,0,0,0,85,1,0,0,0,0,0,0,0,0,80,85,85,1,0,0,0,0,0,0,0,0,0,0,0,0,80,5,0,84,5,0,0,0,0,0,80,85,85,85,1,0,0,0,0,0,0,0,0,0,0,0,64,5,0,84,85,0,0,0,0,0,64,85,85,85,85,1,0,0,0,0,0,0,0,0,0,0,0,84,0,84,85,5,0,0,0,0,0,84,85,85,85,21,0,0,0,0,0,0,0,0,0,0,0,64,5,80,85,0,0,0,0,0,0,84,165,106,85,85,1,0,0,0,0,0,0,0,0,0,0,0,0,0,85,1,0,0,0,0,0,64,85,170,90,85,21,0,0,0,0,0,0,0,0,0,0,0,0,0,84,1,0,0,0,0,0,0,84,169,170,90,85,1,0,0,0,0,0,0,0,0,0,0,0,0,64,21,0,0,0,0,0,0,64,149,170,170,85,21,0,0,0,0,0,0,0,0,0,0,0,0,64,85,0,0,0,0,0,0,64,85,170,170,106,85,1,0,0,0,0,0,0,0,0,0,0,0,0,84,0,0,0,0,0,0,64,85,85,165,170,86,5,0,0,0,0,0,0,0,0,0,0,0,0,64,21,0,0,0,0,0,0,85,85,85,169,106,85,0,0,0,0,0,0,0,0,0,0,0,0,0,84,0,0,0,0,0,0,85,85,85,85,165,86,1,0,0,84,85,1,0,0,0,0,0,0,0,64,5,0,0,0,0,0,80,85,85,85,85,106,21,0,0,64,85,21,0,0,0,0,0,0,0,0,0,0,0,0,0,0,80,149,170,170,106,85,85,1,0,64,85,85,5,0,0,0,0,0,0,0,0,0,0,0,0,0,0,85,169,170,170,90,85,21,0,0,84,85,85,0,0,0,0,0,0,0,0,0,0,0,80,85,85,85,169,170,170,170,90,21,0,0,84,85,85,85,0,0,0,0,0,0,0,0,0,0,80,85,85,85,149,170,170,170,170,85,1,0,64,85,85,85,5,0,0,0,0,0,0,0,0,0,0,85,85,85,149,170,170,170,170,170,86,1,0,85,85,85,85,21,0,0,0,0,84,85,21,0,0,84,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
0,0,80,85,85,85,5,0,84,85,85,5,0,0,165,86,0,0,0,0,0,80,85,85,85,0,0,0,80,85,85,85,5,0,80,85,21,0,80,1,80,21,0,0,0,0,0,80,85,85,85,0,0,0,80,85,85,85,5,0,80,85,21,0,80,1,80,21,0,0,0,0,0,0,85,85,21,0,0,0,64,85,85,85,1,0,0,0,0,0,144,22,0,0,0,0,0,0,0,0,0,0,0,0,0,0,0,0,0,0,0,0,0,0,0,0,144,21,0,0,0,0,0,0,0,0,0,0,0,0,0,0,0,0,0,0,0,0,0,0,0,0,80,21,0,0};
inline constexpr Sprite cow_think={104,86,cow_think_data};
inline constexpr uint8_t cow_back_data[]={0,0,0,0,0,0,0,0,85,85,5,0,0,0,0,0,0,0,0,0,0,0,0,0,0,0,0,0,0,80,85,85,0,0,0,0,0,0,0,0,0,0,0,0,0,0,0,0,0,0,80,85,85,85,0,0,0,0,0,0,0,0,0,0,0,0,0,0,0,0,0,0,85,85,85,5,0,0,0,0,0,0,0,0,0,0,0,0,0,0,0,0,64,85,85,85,85,5,0,0,0,0,0,0,0,0,0,0,0,0,0,0,0,0,84,85,85,85,85,0,0,0,0,0,0,80,5,0,0,0,0,0,0,0,0,84,85,85,85,85,5,0,0,0,0,0,0,85,5,0,0,0,0,0,0,0,64,85,85,85,85,85,0,0,0,0,0,0,80,85,0,0,0,0,0,0,0,0,85,85,85,85,85,5,0,0,0,0,0,0,80,85,0,0,0,0,0,0,0,80,85,85,85,85,85,0,0,0,0,0,0,0,85,21,0,0,0,0,0,0,0,85,85,85,85,85,5,0,0,0,0,0,0,64,85,1,0,0,0,0,0,0,84,85,85,85,85,5,0,0,0,0,0,0,0,80,85,0,0,0,0,0,0,64,85,85,85,85,85,0,0,0,0,0,0,0,0,85,5,0,0,0,0,0,0,84,85,85,85,85,0,0,0,0,0,0,0,0,0,85,0,0,0,0,0,0,64,85,85,85,85,5,0,0,0,0,0,0,0,0,80,5,0,0,0,0,0,0,84,85,85,85,5,0,0,0,0,0,0,0,0,0,85,0,0,0,0,0,0,64,85,85,85,85,0,0,0,0,0,0,0,0,0,80,5,0,0,0,0,0,0,64,85,85,85,0,0,0,0,0,0,0,84,21,0,0,0,0,0,0,0,0,0,84,85,85,0,0,0,0,0,0,0,64,85,1,0,0,0,0,0,0,0,0,80,85,0,0,0,0,0,0,0,0,0,84,85,1,0,0,0,0,64,21,0,0,85,5,0,0,0,0,0,0,0,0,64,85,21,0,0,0,80,1,84,1,0,80,21,0,0,0,0,0,0,0,0,64,85,85,1,0,0,64,21,84,5,0,0,85,1,0,0,0,64,85,85,1,64,85,105,85,0,0,0,85,64,21,0,0,80,21,0,0,0,80,85,85,85,1,84,149,86,5,0,0,80,5,84,1,0,0,85,1,0,0,64,85,85,85,21,64,85,105,85,0,0,0,21,80,5,0,0,80,85,0,80,85,85,85,85,85,85,85,169,106,5,0,0,85,1,85,0,0,0,84,85,85,85,85,85,85,85,85,85,149,170,86,0,0,80,5,84,1,0,0,64,85,85,85,85,85,85,85,85,85,149,170,106,5,0,0,21,80,21,0,0,0,80,85,85,165,170,106,85,85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
21,0,0,0,0,0,0,0,0,0,0,0,0,0,0,0,0,64,85,85,85,85,1,0,0,0,0,0,0,0,0,0,0,0,0,0,0,0,0,84,85,85,85,21,0,0,0,0,0,0,0,0,0,0,0,0,0,0,0,0,0,84,85,85,21,0,0,0,0,0,0,0,0,0,0,0,0,0,0,0,0,0,64,85,85,85,1,0,0,0,0};
inline constexpr Sprite cow_back={86,100,cow_back_data};
inline constexpr uint8_t cow_alert_data[]={0,0,0,0,0,0,0,0,0,0,0,0,0,0,0,0,0,0,0,0,0,0,0,64,5,0,0,0,0,0,0,0,0,0,0,0,0,0,0,0,0,0,0,0,0,0,0,0,64,5,0,0,0,0,0,0,0,0,0,0,0,0,0,0,0,0,0,0,0,0,0,0,0,80,5,0,0,0,0,0,0,0,0,0,0,0,0,0,0,0,0,0,0,0,0,0,0,0,84,5,0,0,0,0,0,0,0,0,0,0,0,0,0,0,0,0,0,0,0,0,0,0,0,84,5,0,0,0,0,0,0,0,0,0,0,0,0,0,0,0,0,0,0,0,0,0,0,0,85,1,0,0,0,0,0,0,0,0,0,0,0,0,0,0,0,0,0,0,0,0,0,0,0,85,1,0,0,0,0,0,0,0,0,0,0,0,0,0,0,0,0,0,0,0,0,0,0,0,85,1,0,0,0,0,0,0,0,0,0,0,0,0,0,0,0,0,0,0,80,5,0,0,64,21,0,0,0,0,0,0,0,0,0,0,0,0,0,0,0,0,0,0,0,84,85,0,0,64,21,0,0,0,0,0,0,0,0,0,0,0,0,0,0,0,0,0,0,0,84,85,0,0,64,21,0,0,0,0,0,0,0,0,0,0,0,0,0,0,0,0,0,0,0,84,90,5,0,0,0,0,0,0,0,0,0,0,0,0,0,0,0,0,0,0,0,0,0,0,84,90,5,0,0,0,0,0,0,0,0,0,0,0,0,0,64,85,0,0,0,0,0,0,0,85,106,85,0,0,0,0,0,0,0,0,0,0,0,0,0,84,85,0,0,0,0,0,0,64,85,170,85,0,0,0,0,0,0,0,0,0,0,0,0,0,84,85,0,0,0,0,0,0,64,85,170,85,0,0,0,80,0,0,0,0,0,0,0,0,0,85,85,1,0,0,0,0,0,80,149,170,85,0,0,0,85,0,0,0,0,0,0,0,0,0,85,90,1,0,0,84,85,85,85,165,170,85,0,0,0,85,0,0,0,0,0,0,0,0,80,149,90,21,0,80,85,85,85,85,170,170,85,0,0,0,85,0,0,0,0,0,0,0,0,80,149,90,21,64,85,85,85,85,85,170,170,85,0,0,0,20,0,0,0,0,0,0,0,0,80,149,106,85,85,85,85,85,85,85,165,170,85,0,0,0,0,0,0,0,0,0,0,0,0,80,149,170,86,85,85,85,85,85,170,85,90,85,0,0,0,0,0,0,0,0,0,0,0,0,64,149,170,86,85,85,85,85,85,170,85,89,85,0,0,0,0,0,0,0,0,0,0,0,0,64,149,170,106,85,85,85,85,85,170,106,85,85,85,21,0,0,0,0,0,0,0,0,0,0,64,149,170,106,85,85,85,85,149,170,106,85,85,85,85,5,0,0,0,0,0,0,0,0,0,80,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
,85,85,21,85,85,85,85,0,0,0,0,0,0,0,0,0,0,0,84,85,85,1,0,64,85,85,85,21,84,85,85,85,0,0,0,0,0,0,0,0,0,0,0,0,0,0,0,0,0,84,85,85,5,80,85,85,5,0,0,0,0,0,0,0,0,0,0,0,0,0,0,0,0,0,84,85,85,5,80,85,85,5,0,0,0,0,0,0,0,0};
inline constexpr Sprite cow_alert={100,88,cow_alert_data};
inline constexpr uint8_t cow_drink_data[]={0,0,0,0,0,0,0,0,0,0,0,0,0,0,0,84,21,0,0,0,0,0,0,0,0,0,0,0,0,0,0,0,0,0,0,0,0,80,85,0,0,0,0,0,0,0,0,0,0,0,85,5,0,0,0,0,0,0,0,64,85,21,0,0,0,0,0,0,0,0,0,0,84,21,0,0,0,0,0,0,0,0,85,85,0,0,0,0,0,0,0,0,0,64,85,85,0,0,0,0,0,0,0,0,84,85,21,0,0,0,0,0,0,0,0,0,85,85,1,0,0,0,0,0,0,0,80,169,85,0,0,0,0,0,0,0,0,64,85,165,85,0,0,0,0,0,0,0,84,165,90,5,0,0,0,0,0,0,0,0,85,165,86,1,0,0,0,0,0,0,80,149,106,21,0,0,0,0,0,0,0,0,85,165,90,21,0,0,0,0,0,0,84,149,170,86,5,0,0,0,0,0,0,0,84,149,106,85,1,0,0,0,0,0,80,85,170,90,21,0,0,0,0,0,0,0,84,165,170,90,21,80,85,85,85,85,64,85,170,106,85,0,0,0,0,0,0,0,80,149,170,106,85,85,85,85,85,85,85,85,170,170,85,1,0,0,0,0,0,0,64,85,170,170,90,85,85,85,85,85,85,149,170,170,86,5,0,0,0,0,0,0,0,85,169,170,106,85,85,85,85,85,85,85,170,170,90,21,0,0,0,0,0,0,0,84,165,170,170,86,85,85,85,85,85,85,165,170,106,85,0,0,0,0,0,0,0,80,149,170,170,90,85,85,85,85,170,170,85,165,106,85,1,0,0,0,0,0,0,64,85,170,170,106,85,85,85,85,169,170,86,149,170,85,5,0,0,0,0,0,0,0,85,149,170,106,85,85,85,85,165,170,170,90,165,85,21,0,0,0,0,0,0,0,80,85,169,90,85,85,85,85,149,170,170,170,85,85,21,0,0,0,0,0,0,0,0,85,149,90,85,85,85,85,165,170,170,170,90,85,21,0,0,0,0,0,0,0,0,84,85,85,85,85,85,85,149,170,170,170,106,85,85,85,85,85,1,0,0,0,0,0,85,85,85,85,85,85,85,170,170,170,170,86,85,85,85,85,5,0,0,84,85,85,85,85,85,85,85,85,85,170,170,170,170,170,85,85,85,85,85,1,0,80,85,85,85,85,85,85,85,85,85,169,170,170,170,170,90,85,85,85,85,5,80,85,85,85,85,85,85,85,85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
170,170,170,170,21,0,0,0,0,0,0,0,80,85,90,170,170,170,170,170,106,21,0,0,0,0,0,0,0,0,80,85,169,170,170,170,170,90,5,0,0,0,0,0,0,0,0,80,85,149,170,170,170,106,85,1,0,0,0,0,0,0,0,0,0,0,85,85,85,85,85,21,0,0,0,0,0,0,0,0,0,0,0,85,85,85,85,85,1,0,0,0,0,0,0,0,0,0,0,0,64,85,85,85,85,0,0,0,0};
inline constexpr Sprite cow_happy={68,66,cow_happy_data};
inline constexpr uint8_t cow_sad_data[]={0,0,0,0,0,0,0,0,0,0,0,0,64,85,0,0,0,0,0,0,0,0,0,0,0,0,0,0,0,0,64,85,0,0,0,0,0,0,0,64,85,0,0,0,0,0,0,0,64,85,0,0,0,0,0,0,0,64,85,0,0,0,0,0,0,0,84,106,5,0,0,0,0,0,0,84,85,5,0,0,0,0,0,0,84,106,5,0,0,0,0,0,0,84,106,5,0,0,0,0,0,0,84,106,85,0,0,0,0,0,0,84,106,5,0,0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
inline constexpr Sprite cow_sad={72,64,cow_sad_data};
inline constexpr uint8_t cow_surprised_data[]={0,0,0,0,0,0,0,0,0,0,0,0,0,80,5,0,0,0,0,0,0,0,0,0,0,0,0,0,0,0,0,80,5,0,0,0,0,0,0,0,0,0,80,1,0,0,0,0,0,80,5,0,0,0,0,0,0,0,0,0,80,1,0,0,0,0,0,80,5,0,0,0,0,0,0,0,0,0,64,1,0,0,0,0,0,80,5,0,0,0,0,0,0,80,0,0,64,1,0,0,0,0,0,80,5,0,0,0,0,0,0,84,0,16,80,1,0,0,0,0,0,80,5,0,0,0,0,0,0,84,1,80,80,1,0,0,0,0,0,80,5,0,0,0,0,0,0,64,1,80,80,1,0,0,0,0,0,80,5,0,0,0,0,0,0,64,21,64,80,0,0,0,0,0,0,80,5,0,0,0,0,0,0,0,21,64,81,0,0,0,0,0,0,64,1,0,0,0,0,0,0,0,84,0,80,0,0,0,84,1,0,64,1,0,0,0,0,0,0,0,80,0,0,0,0,0,84,5,0,64,1,0,0,0,0,0,0,0,0,0,0,0,0,0,165,22,0,64,1,0,0,0,0,0,84,1,0,0,0,0,0,0,165,22,0,64,1,0,0,0,0,0,85,5,0,0,0,0,0,0,165,86,1,0,0,0,0,0,0,0,165,22,0,0,0,0,0,0,165,90,1,0,0,0,0,0,0,80,165,22,0,0,0,0,0,85,165,90,1,80,5,0,0,0,0,80,169,22,0,0,0,0,0,85,169,90,1,80,5,0,0,0,0,80,169,86,1,80,85,85,85,85,170,90,1,80,1,0,0,0,0,80,169,86,65,85,85,85,85,165,170,90,1,0,0,0,0,0,0,80,169,90,85,85,85,85,85,165,170,90,1,0,0,0,0,0,0,80,169,90,85,85,85,85,169,85,170,86,1,0,0,0,0,0,0,80,169,170,86,85,85,85,169,90,169,86,0,0,0,0,0,0,0,80,165,170,86,85,85,85,169,170,165,85,0,0,0,0,0,0,0,64,165,170,85,85,85,85,170,170,86,21,0,0,0,0,0,0,0,64,149,106,85,85,85,85,170,170,86,85,80,85,21,0,0,0,0,0,85,90,85,85,85,149,170,170,106,85,85,85,85,1,0,0,0,0,84,85,85,85,85,149,170,170,170,86,85,85,85,21,0,0,80,85,85,85,85,85,85,149,170,170,170,86,85,169,106,21,0,0,80,85,85,85,85,85,85,169,170,170,170,90,85,170,170,22,0,0,85,85,85,85,85,85,85,169,170,170,170,90,149,170,170,22,0,0,85,85,85,85,85,85,85,170,170,170,170,106,165,85,169,22,0,0,5,0,84,85,85,85,149,170,170,170,170,106,85,149,106,21,0,0,0,0,64,85,85,85,165,170,170,170,106,105,85,165,90,5,0,0,0,85,1,85,85,85,105,165,170,170,90,165,150,170,86,1,0,0,0,85,1,85,85,85,105,149,170,170,86,149,86,170,85,0,0,0,1,80,21,85,85,149,90,149,170,170,150,150,86,85,21,0,0,0,5,64,21,85,85,165,154,150,170,170,150,150,86,85,1,0,0,0,21,0,0,85,85,169,154,150,170,170,150,150,106,1,0,0,0,0,85,1,80,85,169,170,154,154,170,170,150,150,106,1,0,0,0,0,84,85,85,86,169,170,154,154,170,170,150,150,106,1,0,0,0,0,64,85,85,170,170,170,154,154,170,170,150,150,106,1,0,0,0,0,0,0,85,170,170,170,90,150,170,170,86,149,106,1,0,0,0,0,0,0,85,170,170,170,90,149,170,170,90,165,106,1,0,0,0,0,0,64,85,170,170,170,106,149,170,170,170,170,106,1,0,0,0,0,0,80,85,170,170,170,170,169,90,85,85,85,105,1,0,0,0,0,0,80,85,170,170,170,170,170,86,85,85,85,85,1,0,0,0,0,0,84,85,170,170,170,170,90,165,170,170,170,86,5,0,0,0,0,0,84,85,170,170,170,170,85,165,170,170,170,86,21,0,0,0,0,0,84,85,169,170,170,106,165,170,170,170,170,170,85,0,0,0,0,0,84,85,169,170,170,90,170,170,170,170,170,170,85,0,0,0,0,0,84,85,165,170,170,90,170,170,170,170,170,170,86,0,0,0,0,0,84,85,149,170,170,165,170,170,170,170,154,170,86,0,0,0,0,0,84,85,149,170,170,165,170,106,169,170,90,170,86,0,0,0,0,0,84,85,85,169,170,165,170,106,169,170,90,170,86,0,0,0,0,0,84,85,85,169,170,165,170,106,169,170,90,170,86,0,0,0,0,0,80,85,85,165,170,165,170,106,169,170,90,170,86,0,0,0,0,0,0,85,85,149,170,165,170,170,170,170,170,170,85,0,0,0,0,0,0,85,85,149,170,165,170,170,170,170,170,170,21,0,0,0,0,0,0,0,85,85,169,150,170,170,170,170,170,106,21,0,0,0,0,0,0,0,0,84,85,85,170,170,170,170,170,86,1,0,0,0,0,0,0,0,0,0,85,85,149,170,170,170,106,85,1,0,0,0,0,0,0,0,0,0,0,80,85,85,85,85,85,21,0,0,0,0,0,0,0,0,0,0,0,80,85,85,85,85,85,1,0,0,0,0,0,0,0,0,0,0,0,0,84,85,85,85,21,0,0,0,0,0,0};
inline constexpr Sprite cow_surprised={72,66,cow_surprised_data};
inline constexpr uint8_t cow_easy_data[]={0,0,0,0,0,0,0,84,85,85,0,0,0,64,85,85,1,0,0,0,0,0,0,0,0,0,0,0,0,0,64,85,85,85,0,0,64,85,85,21,0,0,0,0,0,0,0,0,0,0,0,0,0,0,84,85,85,21,0,0,85,85,85,1,0,0,0,0,0,0,0,0,0,0,0,0,0,64,165,170,90,21,0,85,169,170,21,0,0,0,0,0,0,0,0,0,0,0,0,0,0,84,170,170,90,1,84,169,170,90,1,0,0,0,0,0,0,0,0,0,0,0,0,0,64,165,170,170,85,64,149,170,170,21,0,0,0,0,0,0,0,0,0,0,0,0,0,0,84,169,90,170,5,149,106,169,86,1,0,0,0,0,0,0,0,0,0,0,0,0,0,64,85,170,85,90,85,105,165,106,21,0,0,0,0,0,0,0,0,0,0,0,0,0,0,64,165,170,149,86,165,149,170,85,0,0,0,0,0,0,0,0,0,0,0,0,0,0,0,84,169,106,101,149,150,170,86,5,0,0,0,0,0,0,0,0,0,0,0,0,0,0,0,85,170,106,90,89,170,90,21,0,0,0,0,0,0,0,0,0,0,0,0,84,21,0,80,85,170,90,85,169,106,85,0,0,85,1,0,0,0,0,0,0,0,0,64,85,1,0,80,85,85,85,85,85,85,1,0,80,21,0,0,0,0,0,0,0,0,0,84,21,0,0,85,85,85,85,85,85,5,0,0,85,21,0,0,0,0,0,0,0,0,84,106,21,0,0,84,85,84,81,85,5,0,64,149,90,1,0,0,0,0,0,0,0,64,165,86,1,0,0,0,0,21,0,0,0,0,84,169,21,0,0,0,0,0,0,0,0,84,106,21,0,0,0,0,84,1,0,0,0,64,149,90,21,0,0,0,0,0,0,0,84,165,86,1,0,0,0,64,21,0,0,0,0,80,169,85,1,0,0,0,0,0,0,64,149,106,21,0,0,0,0,84,1,0,0,0,64,149,170,21,0,0,0,0,0,0,0,84,169,86,1,0,0,0,64,21,0,0,0,0,84,169,90,1,0,0,0,0,0,0,64,149,170,85,20,0,80,85,85,85,21,0,64,85,169,170,21,0,0,0,0,0,0,0,84,169,106,85,65,21,85,85,85,85,85,65,85,149,170,90,1,0,0,0,0,0,0,64,149,170,106,85,85,85,85,85,85,85,85,85,85,170,170,21,0,0,0,0,0,0,0,84,169,170,86,85,85,85,85,85,85,85,85,85,170,170,90,1,0,0,0,0,0,0,64,149,170,170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
inline constexpr Sprite cow_expert={88,75,cow_expert_data};
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
