ibnusina339/Remora/firmware/esp32c6/components/remora_ui/include/boot_logo.hpp

#pragma once
#include <cstdint>
namespace remora {
struct LogoRun {uint16_t count,rgba;};
inline constexpr LogoRun BootLogo[]={
{26590,0},
{34,65520},
{284,0},
{2,65520},
{34,0},
{2,65520},
{284,0},
{1,65522},
{1,65525},
{28,65527},
{1,65526},
{1,65524},
{1,65522},
{1,65520},
{3,0},
{1,65520},
{278,0},
{3,65520},
{1,65528},
{32,65533},
{1,65532},
{1,65531},
{1,65528},
{1,65523},
{1,65520},
{1,0},
{2,65520},
{276,0},
{1,65520},
{1,0},
{1,65527},
{1,65534},
{34,65532},
{2,65533},
{1,65530},
{1,65524},
{2,0},
{1,65520},
{274,0},
{1,65520},
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
};
}
