ibnusina339/Remora/(commit log)

2026-10-23 Add modular ESP32-C6 firmware, power policy and OTA pipeline
    [partitions.csv, remora-logo-fusion-r12.dxf, remora-logo.dxf]
2026-10-23 Add five local profiles and personalized first-login tutorial; fix IDF APIs
    [app_main.cpp, audio.cpp, display.cpp, game_engine.cpp, network.cpp, pixel_ui.cpp]
2026-10-23 Verify profiles and power UI; preserve boot logo and game-over responses
2026-10-23 Match native decoder high/low audio and LEDs to its guide
2026-10-26 Fix namespace closure in native ratings storage
    [ratings.cpp]
2026-10-27 Add configurable Auto Off and fix USB console and Wi-Fi event stack on C6
    [app_main.cpp, idle_policy.hpp, pixel_ui.cpp, pixel_ui.hpp]
2026-10-27 Free release JSON before manifest TLS to prevent C6 OTA heap exhaustion
    [ota.cpp]
2026-10-27 Resolve latest stable tag with HEAD to keep OTA metadata memory small
    [ota.cpp]
2026-10-27 Stop unused Wi-Fi and fix C6 audio timer starvation after OTA
    [app_main.cpp, audio.cpp, network.cpp, network_idle_policy.hpp, ota.cpp]
2026-10-27 Verify audio lifecycle and document physical radio power-down results
